turnracing/turnracing-diy/Wiki Images/Printed Grip Molds.jpeg

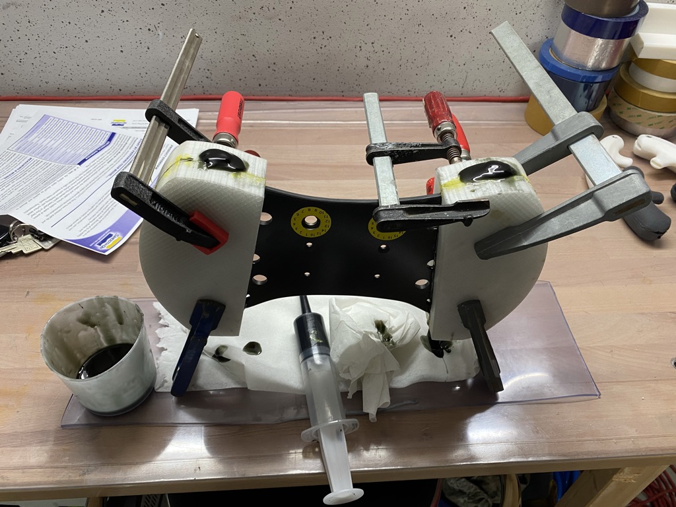
Wiki Images/Printed Grip Molds.jpeg
