turnracing/turnracing-diy/Wiki Images/bead-blasting.png

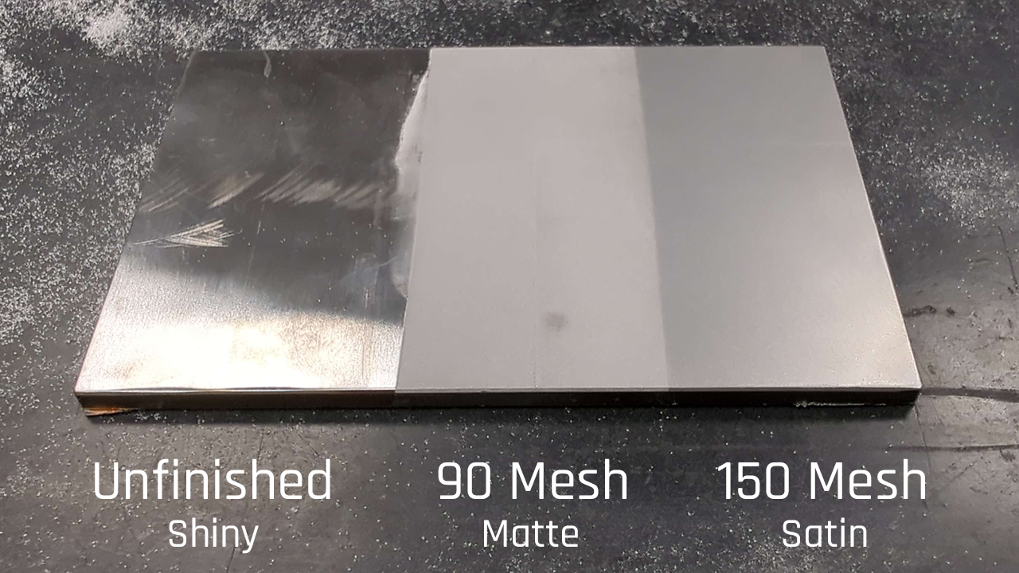
Wiki Images/bead-blasting.png
