turnracing/turnracing-diy/README.md

# Turn Racing DIY
A DIY sim racing archive by the Turn Racing community

Go to our [Wiki](https://github.com/spookeo/turnracing-diy/wiki)
