turnracing/turnracing-diy/Turn DIY Files/Turn 488 Challenge DIY Files/Renderings/Render 4.png

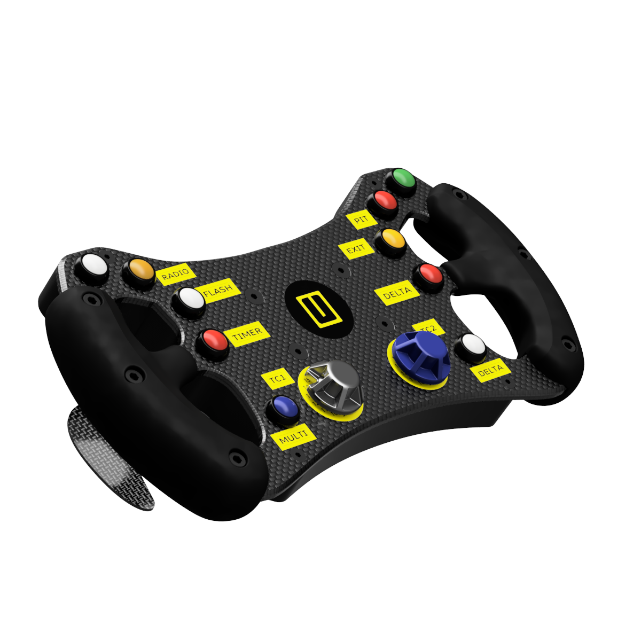
Turn DIY Files/Turn 488 Challenge DIY Files/Renderings/Render 4.png
