turnracing/turnracing-diy/Turn DIY Files/Turn 488 Challenge DIY Files/Stickers/Turn 488 Challenge Sticker Sheet Size A4-01.png

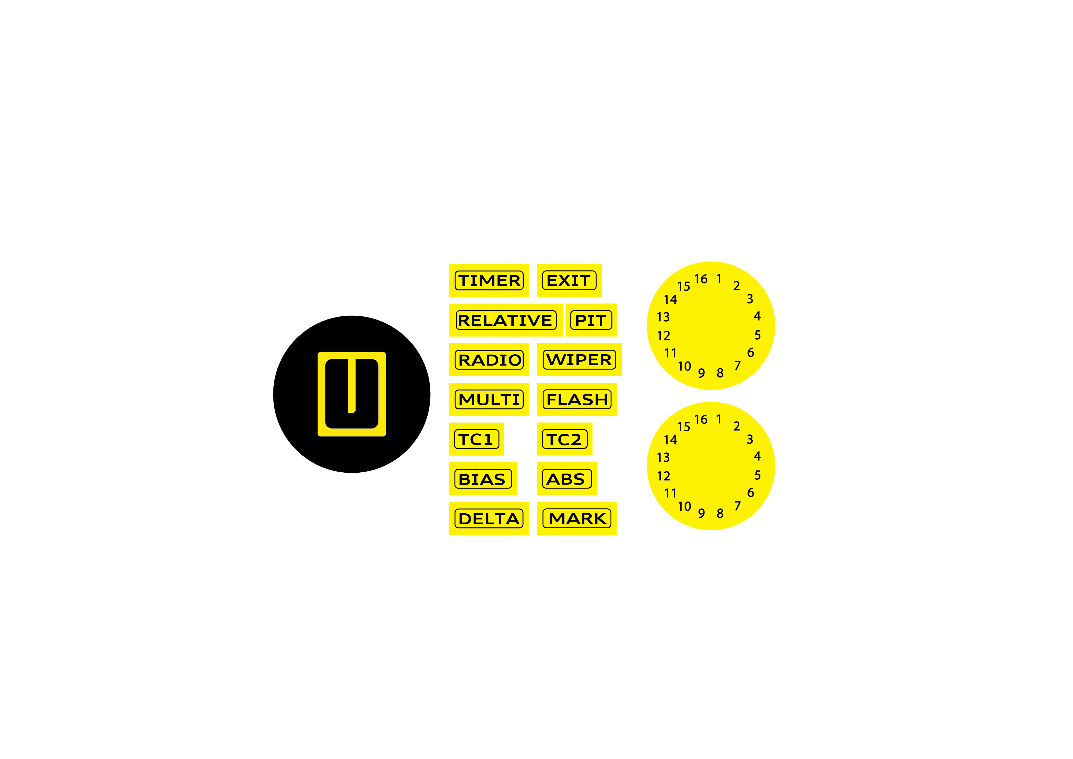
Turn DIY Files/Turn 488 Challenge DIY Files/Stickers/Turn 488 Challenge Sticker Sheet Size A4-01.png
