turnracing/turnracing-diy/Turn DIY Files/Turn 911 GT3 Cup DIY Files/Renderings/Render2.png

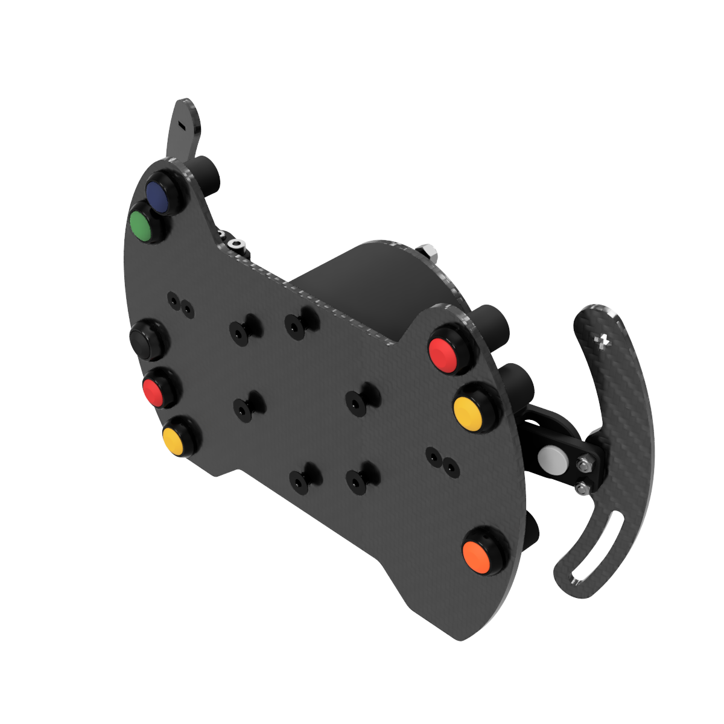
Turn DIY Files/Turn 911 GT3 Cup DIY Files/Renderings/Render2.png
