turnracing/turnracing-diy/Turn DIY Files/Turn 911 GT3 Cup DIY Files/Renderings/Render3.png

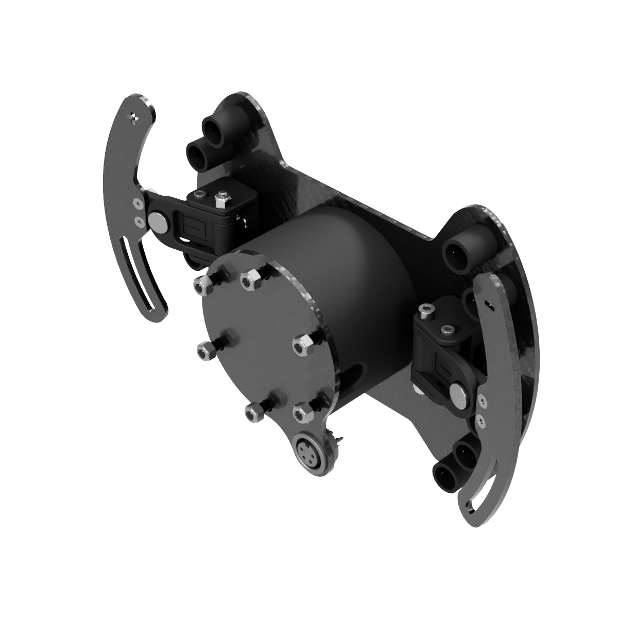
Turn DIY Files/Turn 911 GT3 Cup DIY Files/Renderings/Render3.png
