turnracing/turnracing-diy/Turn DIY Files/Turn Fiesta WRC DIY Files/Renderings/Front View.png

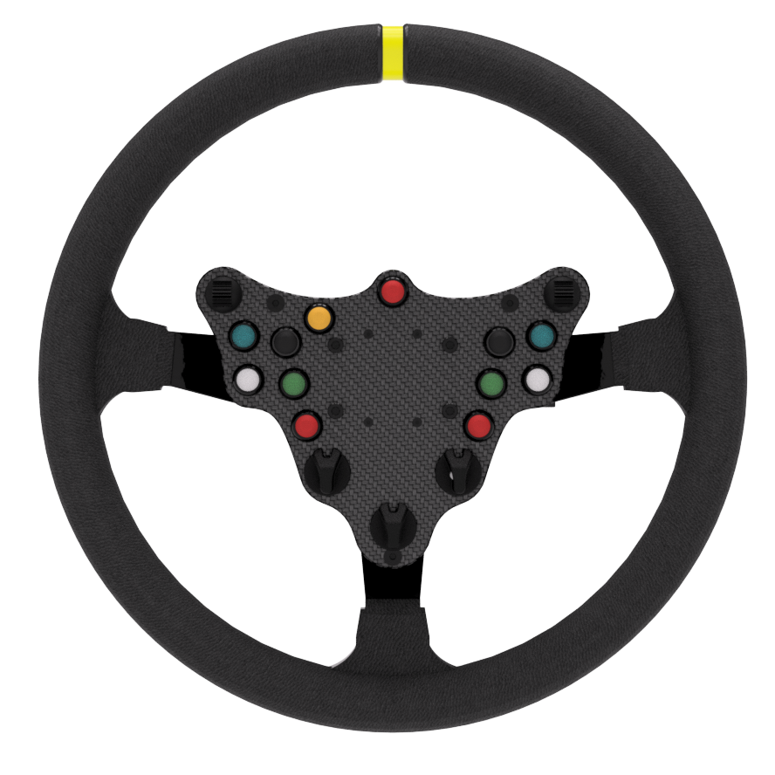
Turn DIY Files/Turn Fiesta WRC DIY Files/Renderings/Front View.png
