turnracing/turnracing-diy/Turn DIY Files/Turn Fiesta WRC DIY Files/Renderings/Rear Isometric View.png

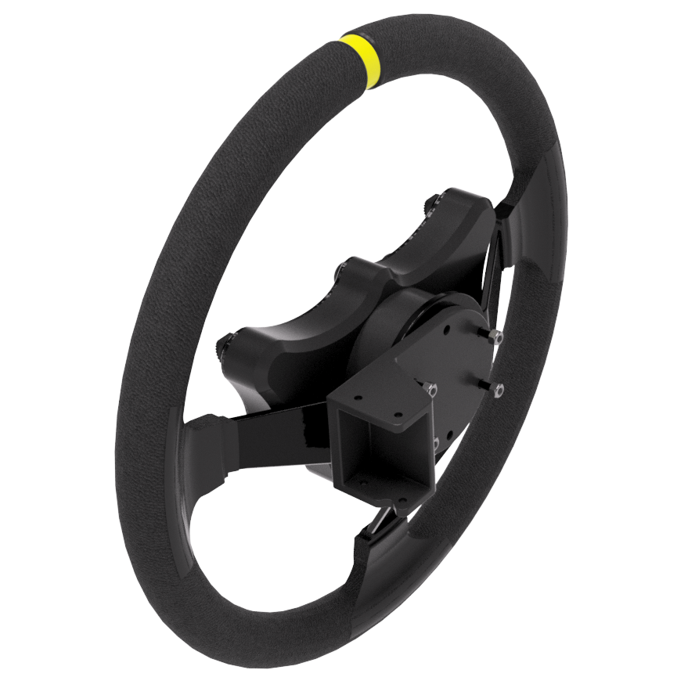
Turn DIY Files/Turn Fiesta WRC DIY Files/Renderings/Rear Isometric View.png
