turnracing/turnracing-diy/Turn DIY Files/Turn Fiesta WRC DIY Files/Stickers/Fiesta WRC Sticker Sheet.png

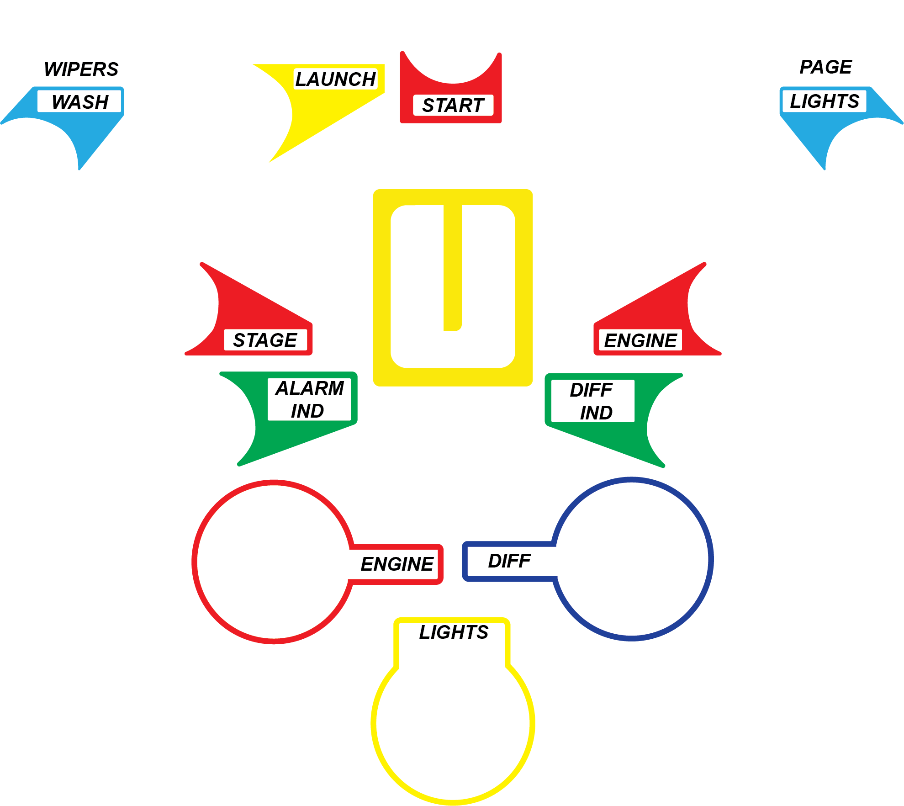
Turn DIY Files/Turn Fiesta WRC DIY Files/Stickers/Fiesta WRC Sticker Sheet.png
