turnracing/turnracing-diy/Turn DIY Files/Turn GT GT3 DIY Files/Renderings/Turn GT GT3 Steering Wheel.2.png

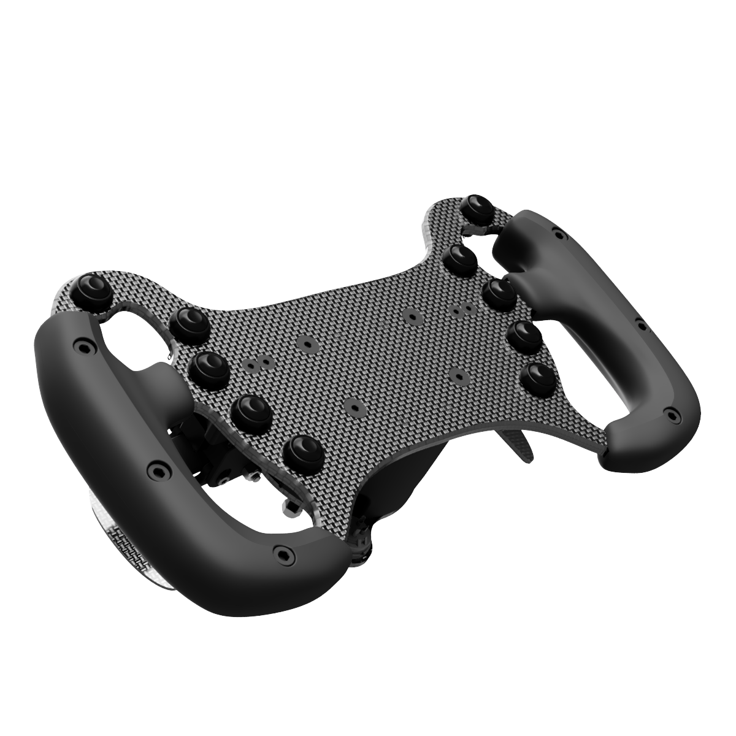
Turn DIY Files/Turn GT GT3 DIY Files/Renderings/Turn GT GT3 Steering Wheel.2.png
