turnracing/turnracing-diy/Turn DIY Files/Turn GT GT3 DIY Files/Renderings/Turn GT GT3 Steering Wheel.png

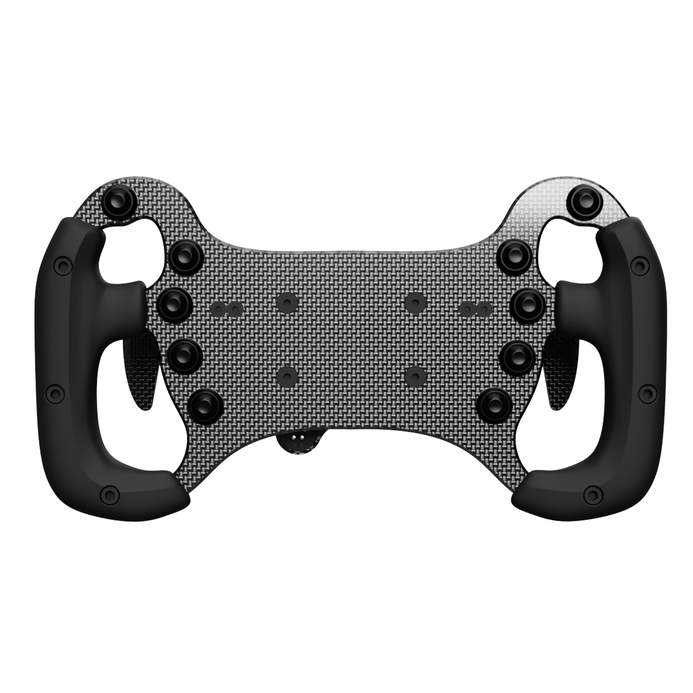
Turn DIY Files/Turn GT GT3 DIY Files/Renderings/Turn GT GT3 Steering Wheel.png
