turnracing/turnracing-diy/Turn DIY Files/Turn GT GT3 DIY Files/Turn 3d Shifter DIY Download/Renderings/Render 2.png

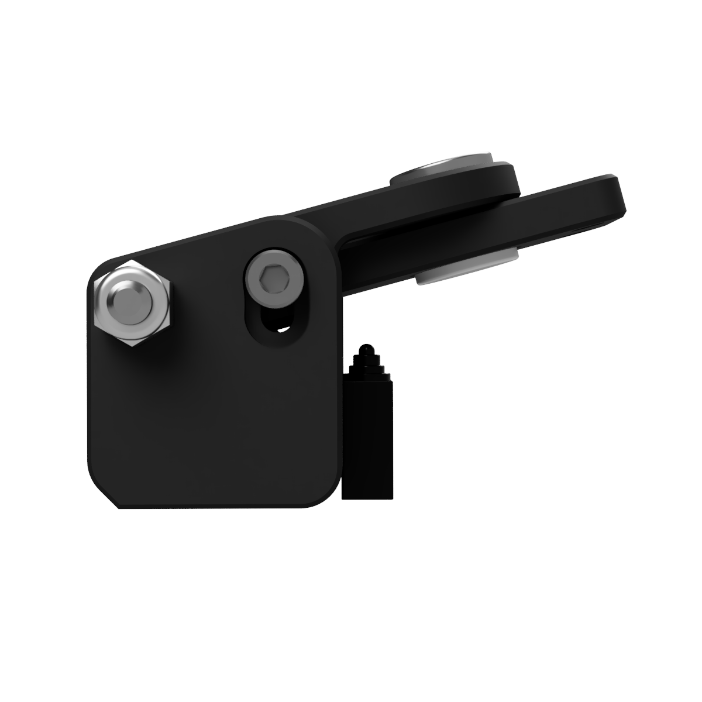
Turn DIY Files/Turn GT GT3 DIY Files/Turn 3d Shifter DIY Download/Renderings/Render 2.png
