turnracing/turnracing-diy/Turn DIY Files/Turn GTE DIY Files/Stickers/Turn GTE Sticker Sheet Size A4-01.png

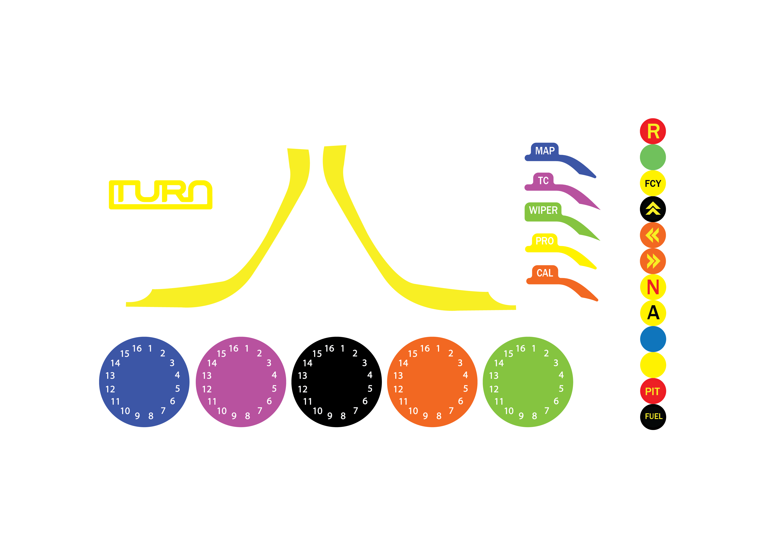
Turn DIY Files/Turn GTE DIY Files/Stickers/Turn GTE Sticker Sheet Size A4-01.png
