turnracing/turnracing-diy/Turn DIY Files/Turn R8 LMS DIY Files/Renderings/Render 1.jpg

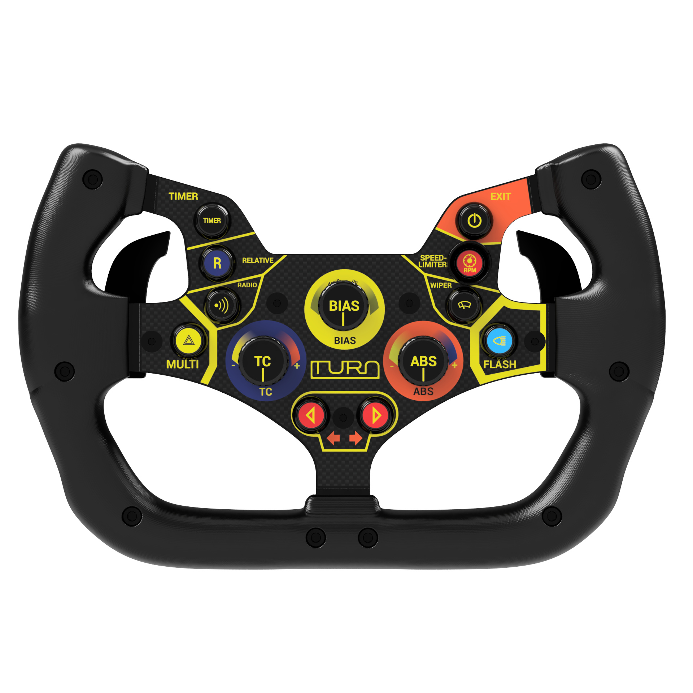
Turn DIY Files/Turn R8 LMS DIY Files/Renderings/Render 1.jpg
