turnracing/turnracing-diy/Turn DIY Files/Turn R8 LMS DIY Files/Stickers/Turn R8 Sticker Sheet Size A4.png

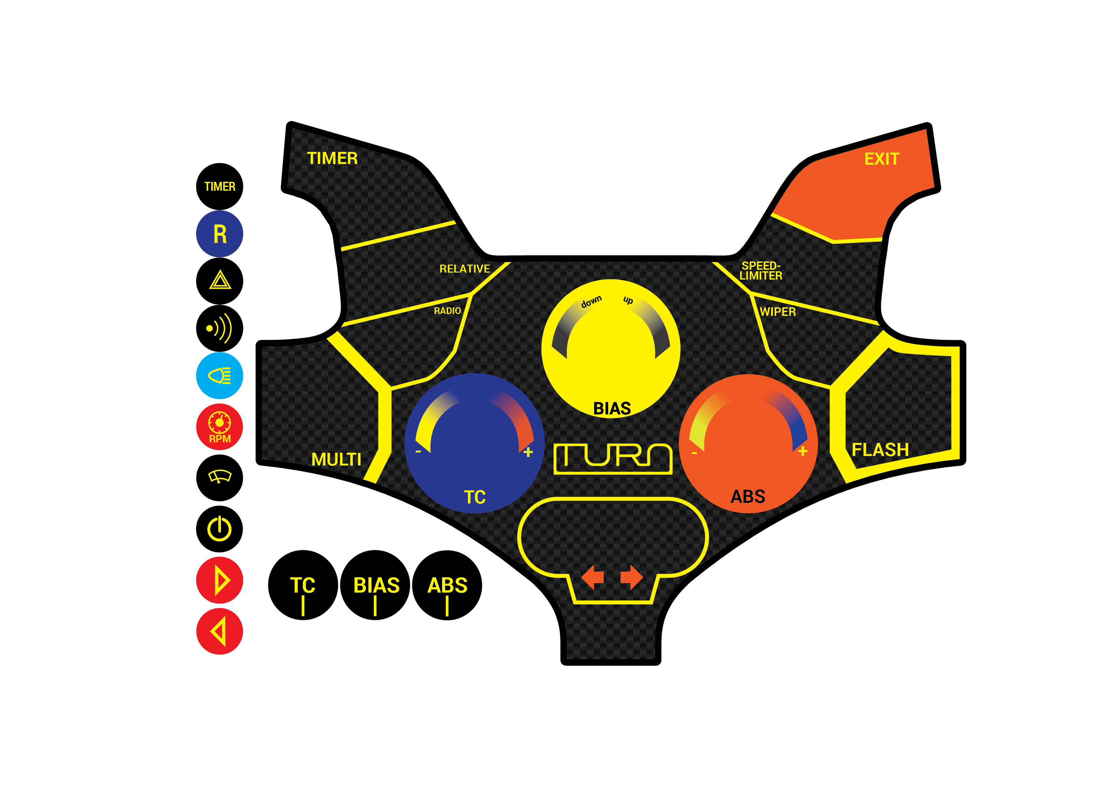
Turn DIY Files/Turn R8 LMS DIY Files/Stickers/Turn R8 Sticker Sheet Size A4.png
