turnracing/turnracing-diy/Turn DIY Files/Turn RSR-17 DIY Files/Renderings/Turn RSR-17 Back Angle.png

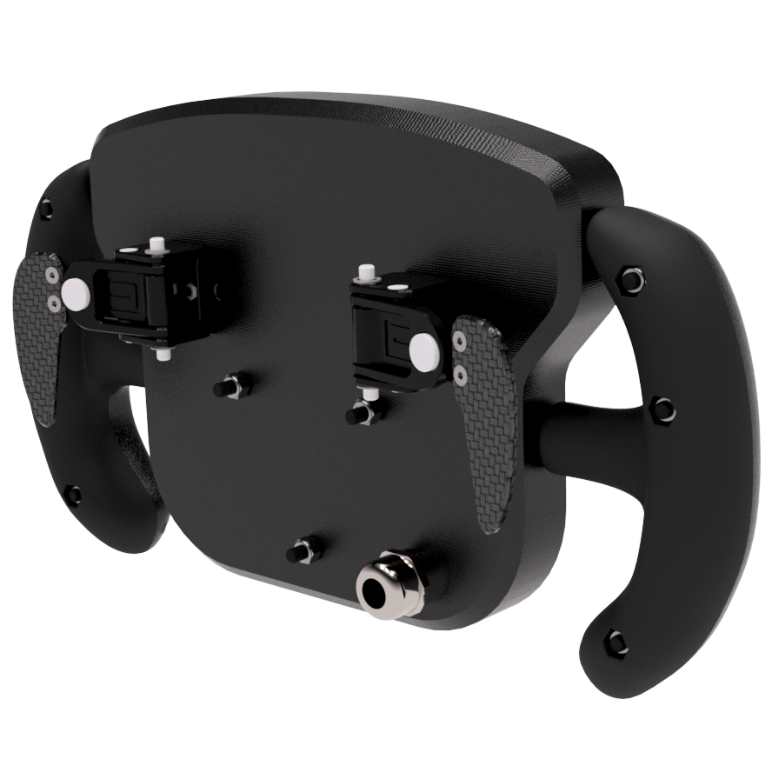
Turn DIY Files/Turn RSR-17 DIY Files/Renderings/Turn RSR-17 Back Angle.png
