turnracing/turnracing-diy/Wiki Images/Carbon-Diagonal-Left.jpg

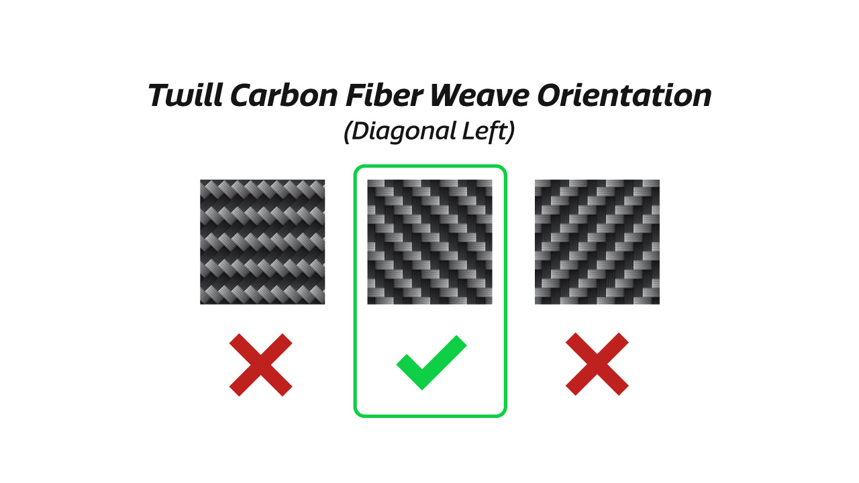
Wiki Images/Carbon-Diagonal-Left.jpg
