turnracing/turnracing-diy/Wiki Images/Carbon-Diagonal-Right.jpg

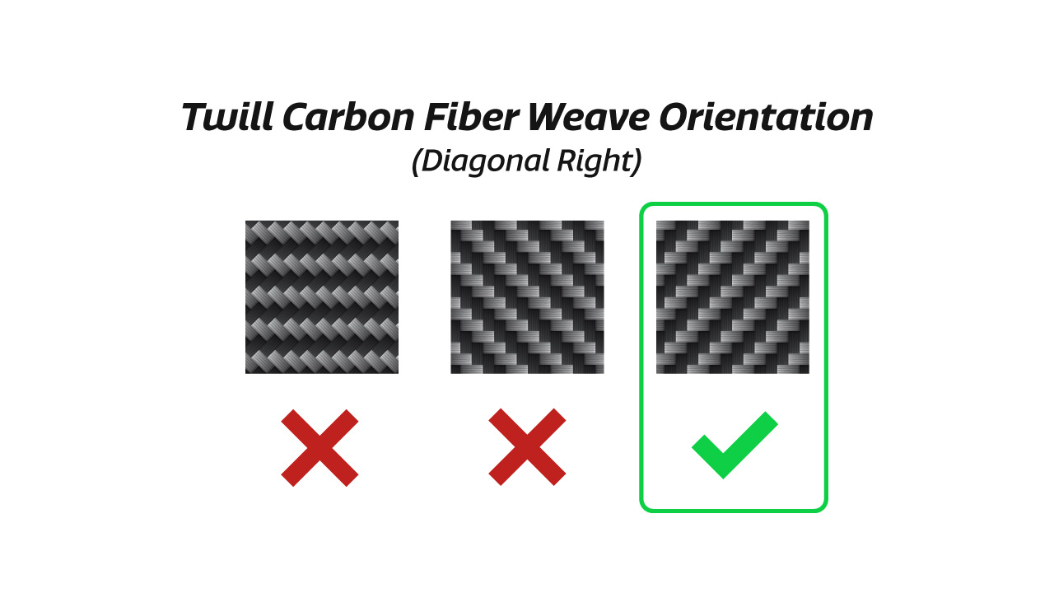
Wiki Images/Carbon-Diagonal-Right.jpg
