turnracing/turnracing-diy/Wiki Images/Fusion Save As Mesh.png

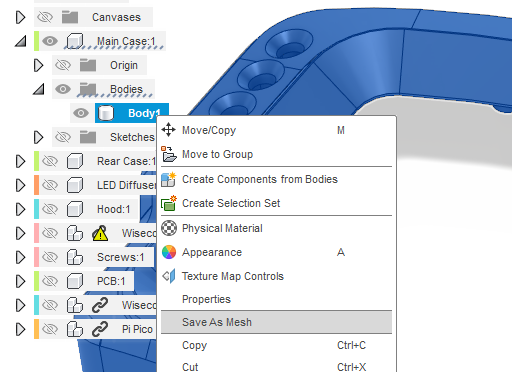
Wiki Images/Fusion Save As Mesh.png
