turnracing/turnracing-diy/Wiki Images/Fusion STL Settings.png

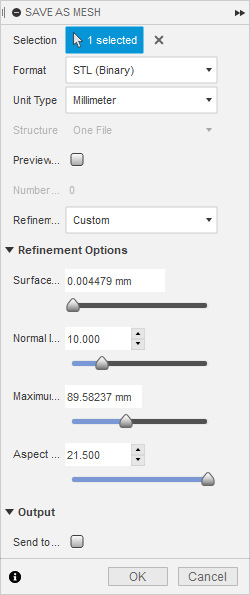
Wiki Images/Fusion STL Settings.png
