turnracing/turnracing-diy/Wiki Images/Schematics/488.png

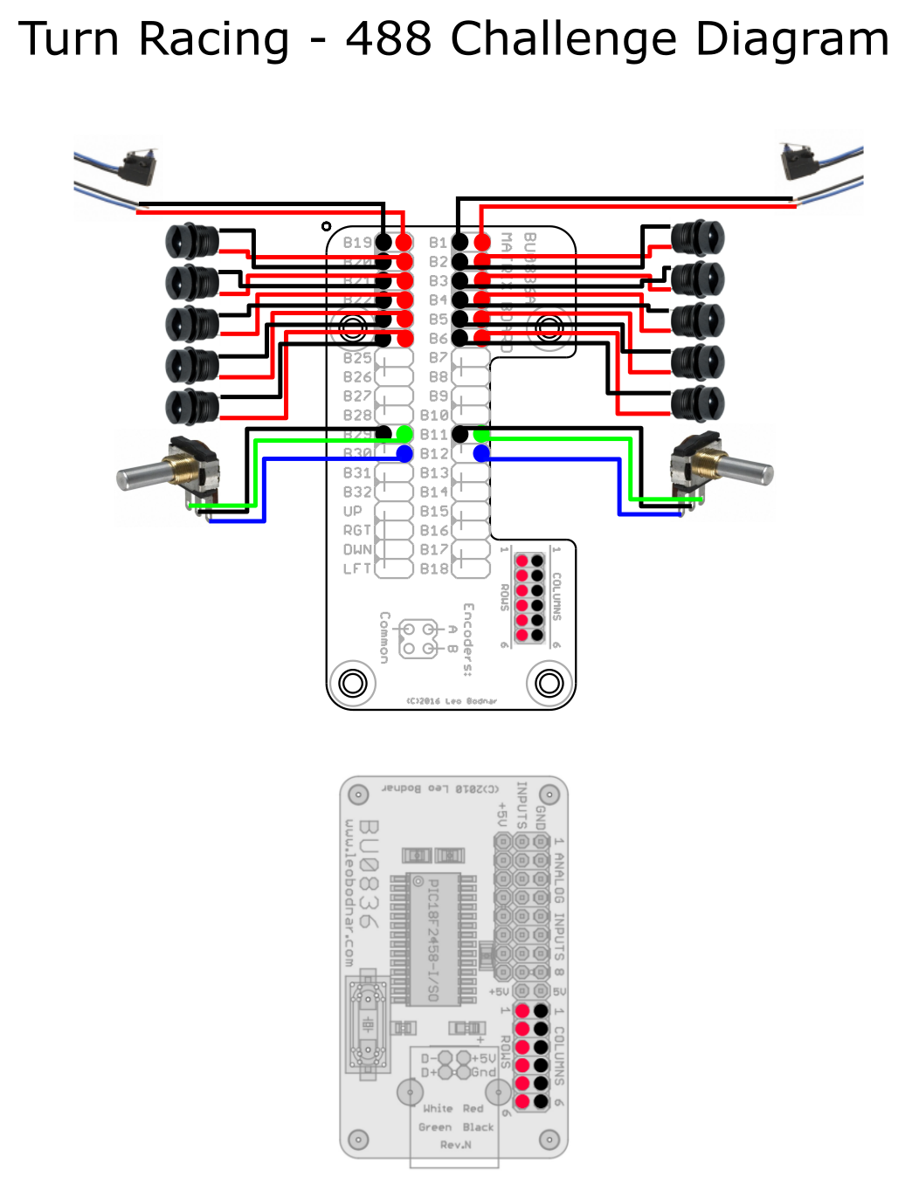
Wiki Images/Schematics/488.png
