turnracing/turnracing-diy/Wiki Images/Schematics/911.png

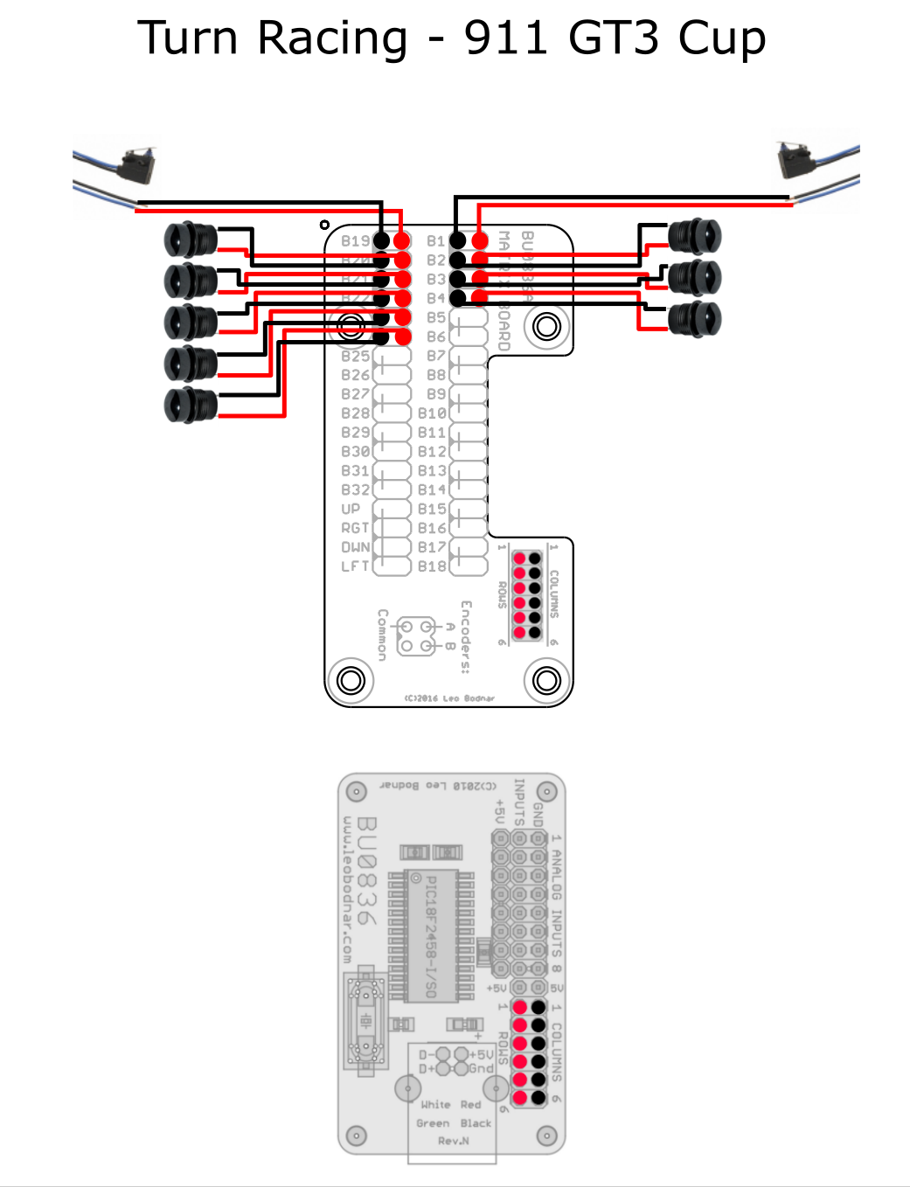
Wiki Images/Schematics/911.png
