turnracing/turnracing-diy/Wiki Images/Schematics/GTE.png

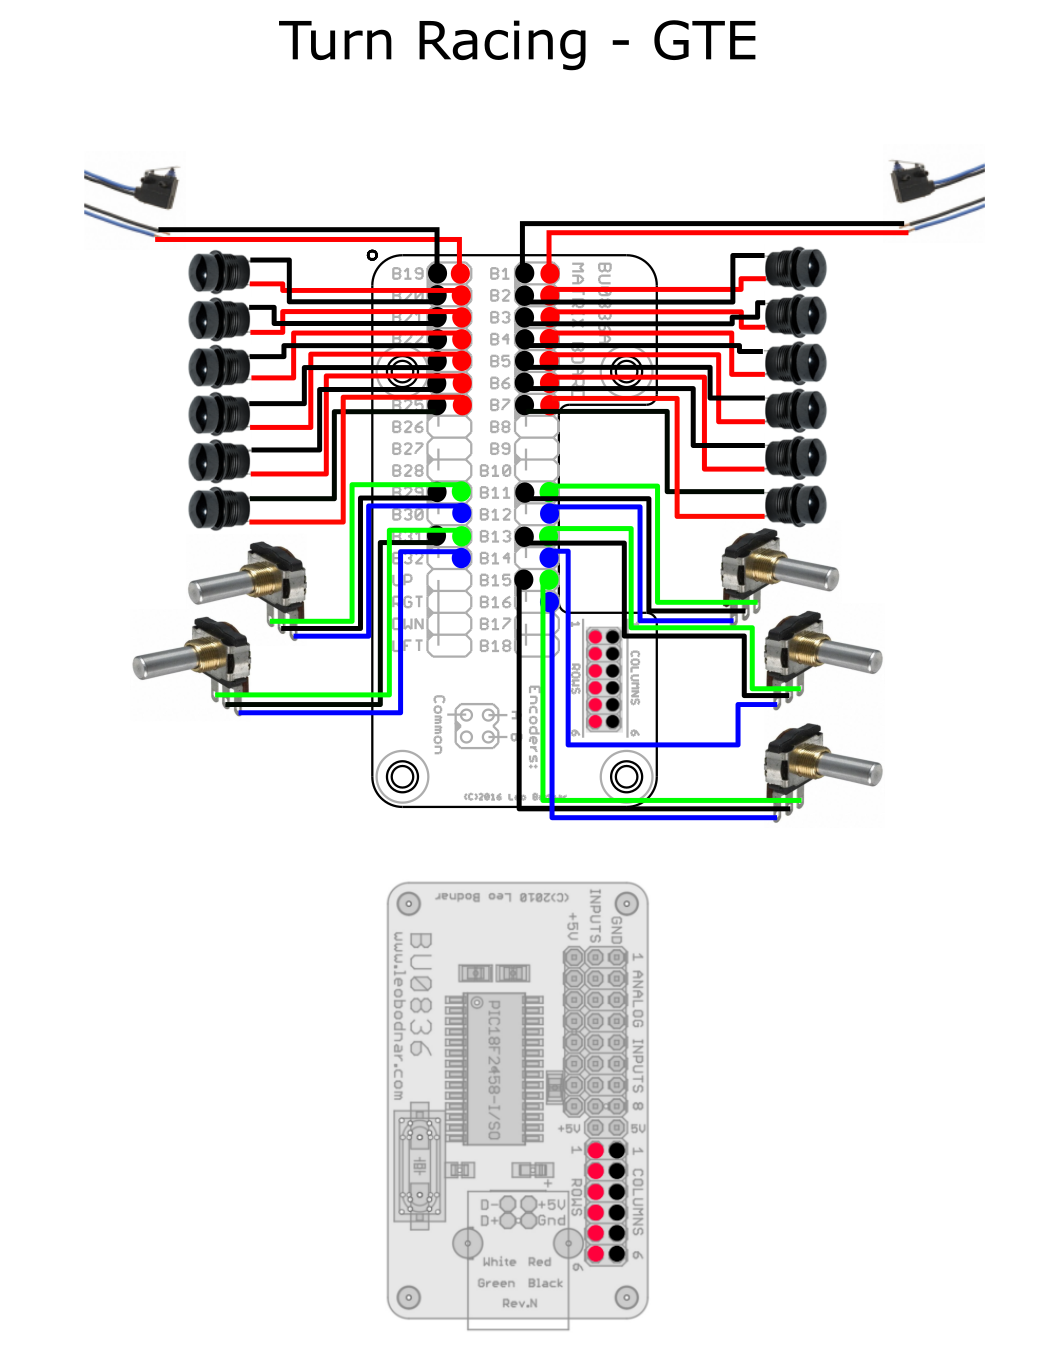
Wiki Images/Schematics/GTE.png
