turnracing/turnracing-diy/Wiki Images/Schematics/R8.png

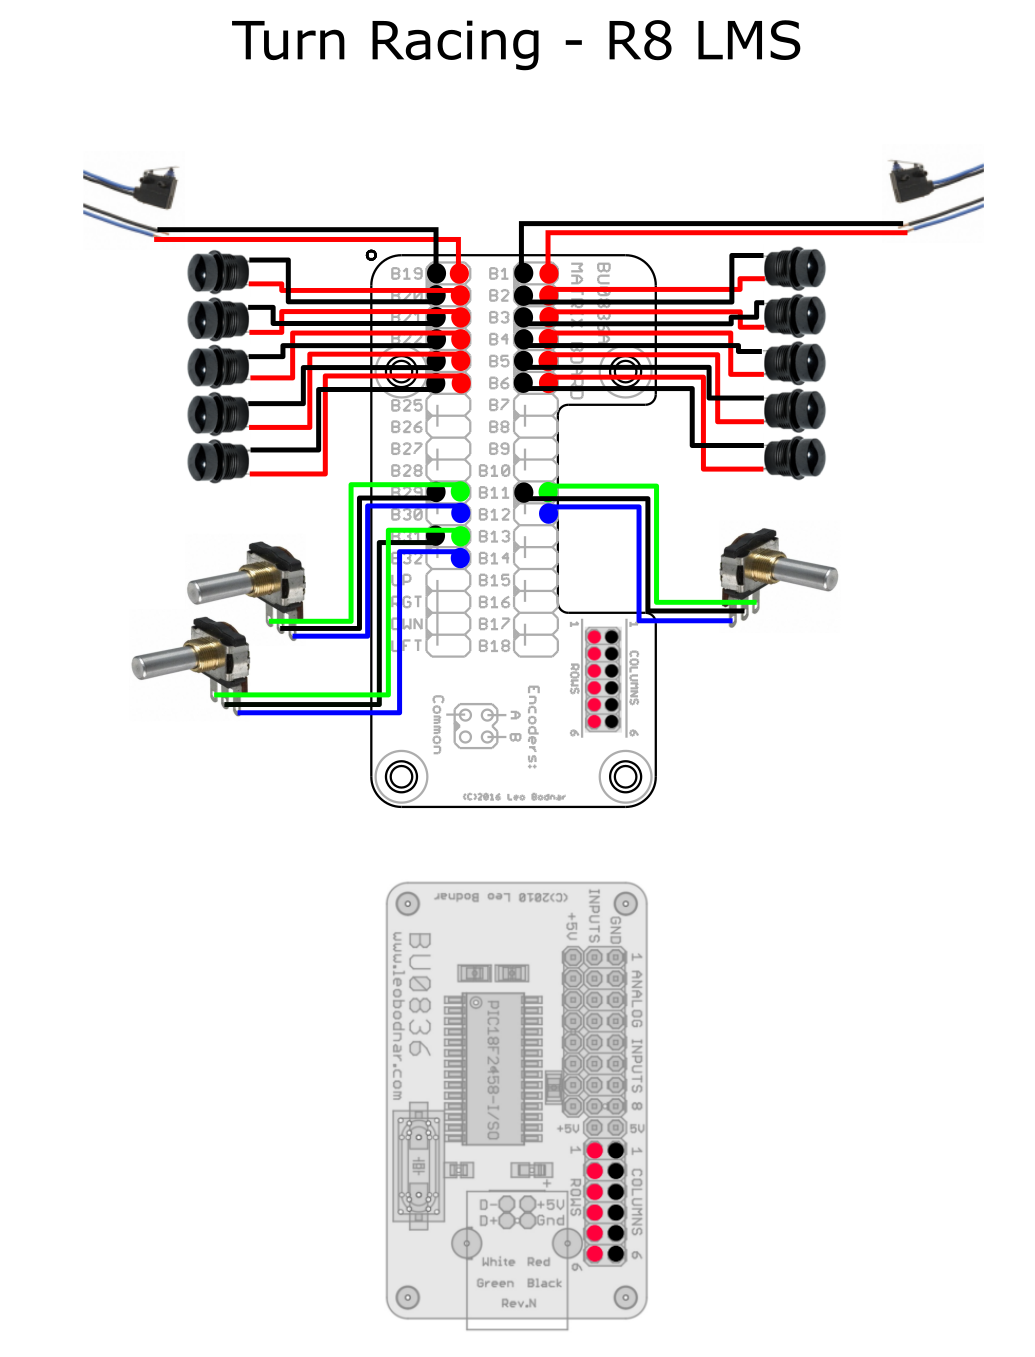
Wiki Images/Schematics/R8.png
