turnracing/turnracing-diy/Wiki Images/turn-wiki-dark.png

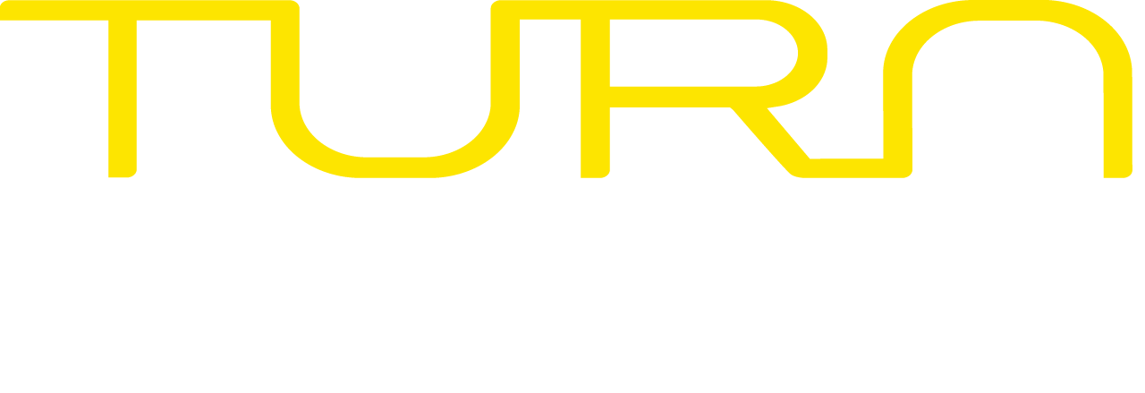
Wiki Images/turn-wiki-dark.png
