turnracing/turnracing-diy/Wiki Images/turn-wiki-light.png

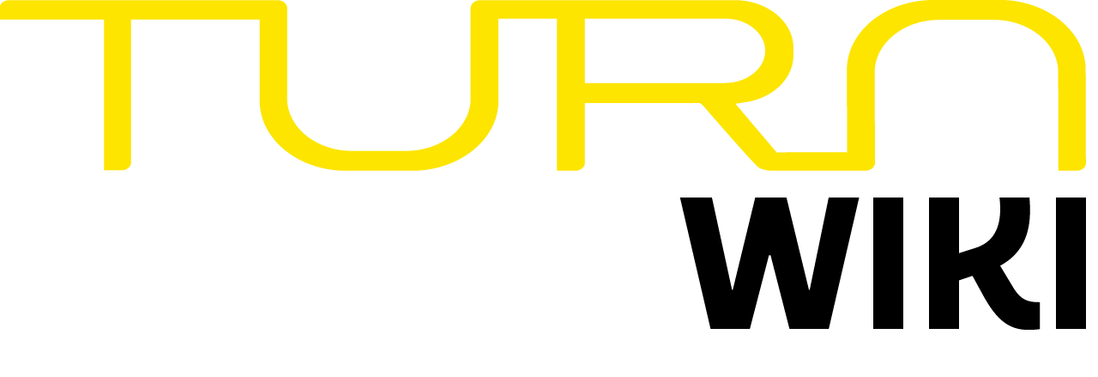
Wiki Images/turn-wiki-light.png
