turnracing/turnracing-diy/Wiki Images/via_stich_2.png

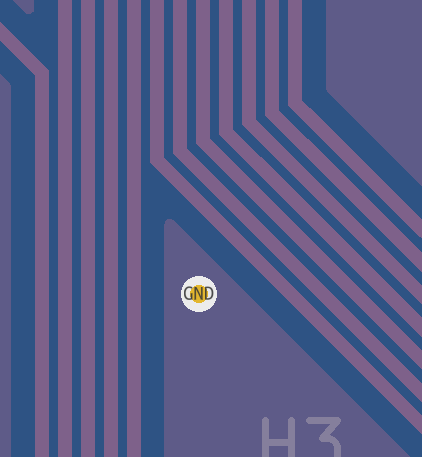
Wiki Images/via_stich_2.png
