turnracing/turnracing-diy/Wiki Images/wheel-size-chart-dark.png

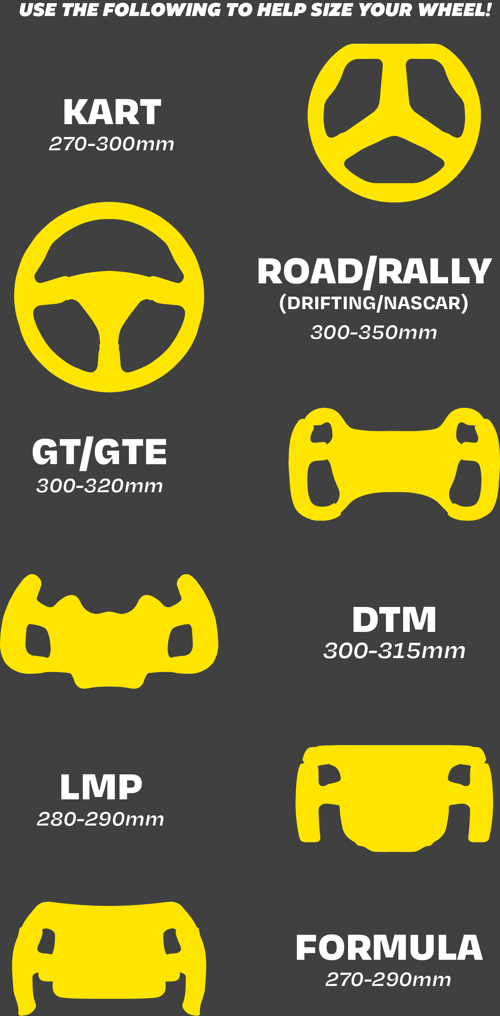
Wiki Images/wheel-size-chart-dark.png
