turnracing/turnracing-diy/Wiki Images/wheel-size-chart-light.png

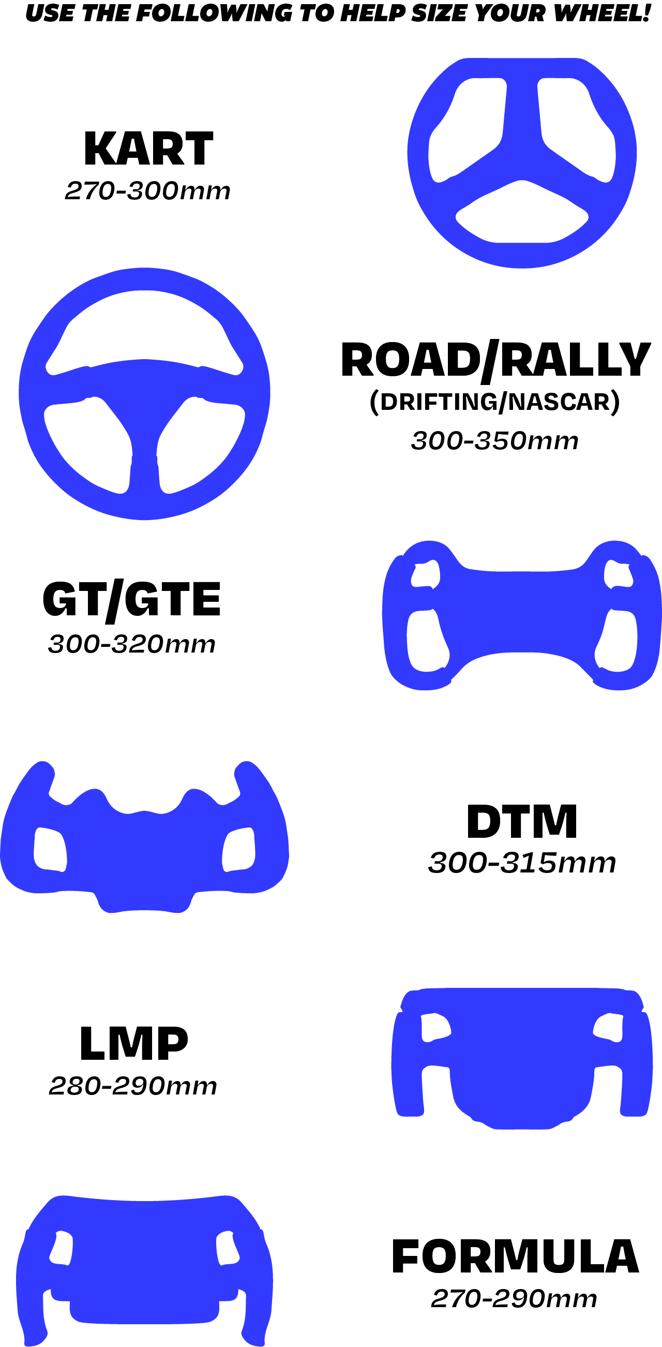
Wiki Images/wheel-size-chart-light.png
