turnracing/turnracing-diy/Turn DIY Files/Turn Fiesta WRC DIY Files/Bill of Materials/Turn Fiesta WRC DIY Bill of Materials.pdf

# TURN Fiesta WRC DIY BILL OF MATERIALS

PRODUCT NAME | Fiesta WRC | CONTACT INFO
APPROVED BY | Zach Hodgson | support@turnracing.com | Hardware Suppliers
TOTAL COST | ($ | 197.98) | https://www.albanycountyfasteners.com/
| | | https://www.accu.co.uk/en/
| | | https://www.gwr-fasteners.co.uk/
PART NUMBER | PART NAME | DESCRIPTION | PART IMAGE | QUANTITY | SUPPLIER / MANUFACTURER | UNIT COST | TOTAL PART COST
BU0836A | USB Controller | A small USB joystick interface board A small add on board that provides an easy matrix circuit for the BU0836A | | 1 | | ($ 35.43) | ($ 35.43)
BU0836A | Breakout Board | | | 1 | | ($ 21.25) | ($ 21.25)
PV5S24011 | E-Switch Push Button | momentary switch | | 12 | | ($ 4.51) | ($ 54.12)
MTG72AD2 | Apem Trim Switch | Toggle Switches SWITCH TOGGLE SEALED MOM-OFF-MOM | | 2 | | ($ 43.49) | ($ 86.98)
CTS 288 Short Shaft | Rotary Encoder | Shaft Length: 10.5mm - 16 detents per revolution - 1 pulse per detent - 1:1 mode in our encoder config software - Shaft diameter: 1/4" | | 3 | | ($ 6.37) | ($ 19.11)
| M2.5 Hexagon Nylon Lock Nut | | | 12 | | ($ 0.62) | ($ 7.44)

http://www.leobodnar.com/shop/index.php?main_page=product_info&cPath=94&products_id=204

http://www.leobodnar.com/shop/index.php?main_page=product_info&cPath=94&products_id=274

https://www.digikey.com/product-detail/en/e-switch/PV5S24011/EG5949-ND/4028816

https://www.mouser.com/ProductDetail/642-MTG72AD2

http://www.leobodnar.com/shop/index.php?main_page=product_info&cPath=98_75&products_id=243

https://www.accu.co.uk/en/hexagon-nylon-locking-nuts/7944-HNN-M3-A2

# TURN Fiesta WRC DIY BILL OF MATERIALS

M5 Hexagon Nylon Lock

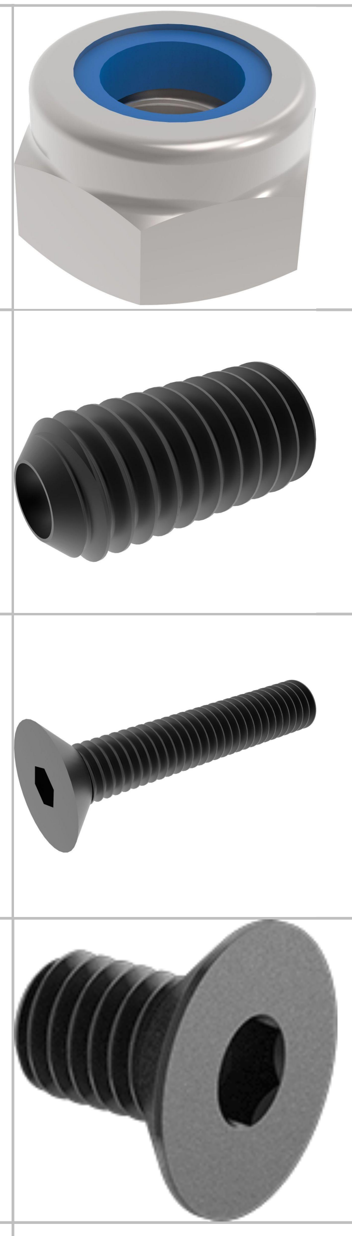
[picture p42: figure]

Nut | 4

https://www.accu.co.uk/en/hexagon-nylon-locking-nuts/7947-HNN-M5-A2

($ | 0.72) | ($ | 2.88)
M4 x 6mm Set Screw | Set Screw for rotary encoder knobs | 3

https://www.accu.co.uk/en/cup-point-set-screws/152976-SSU-M4-6-A2-BL

($ | 0.44) | ($ | 1.32)

M2.5 x 25mm Flat Head
Screw | Flat head Screw | 4

https://www.mcmaster.com/91294A540/

($ | 0.52) | ($ | 2.08)

M3 x 10mm Flat Head
Screw | Flat Head Screw | 3

https://www.accu.co.uk/en/countersunk-socket-head-screws/153275-SSK-M5-10-A2-BL

($ | 0.44) | ($ | 1.32)
M5 x 80mm Socket Screw | Countersunk Screw | 4

https://www.accu.co.uk/en/cap-head-screws/16058-SSC-M5-80-12-9

($ | 0.37) | ($ | 1.48)
TOTAL | ($ | 197.98)

# Copyright © 2020 Turn Racing, LLC. All rights reserved
