turnracing/turnracing-diy/Turn DIY Files/Turn R8 LMS DIY Files/Bill of Materials/Turn R8 LMS DIY Bill of Materials.pdf

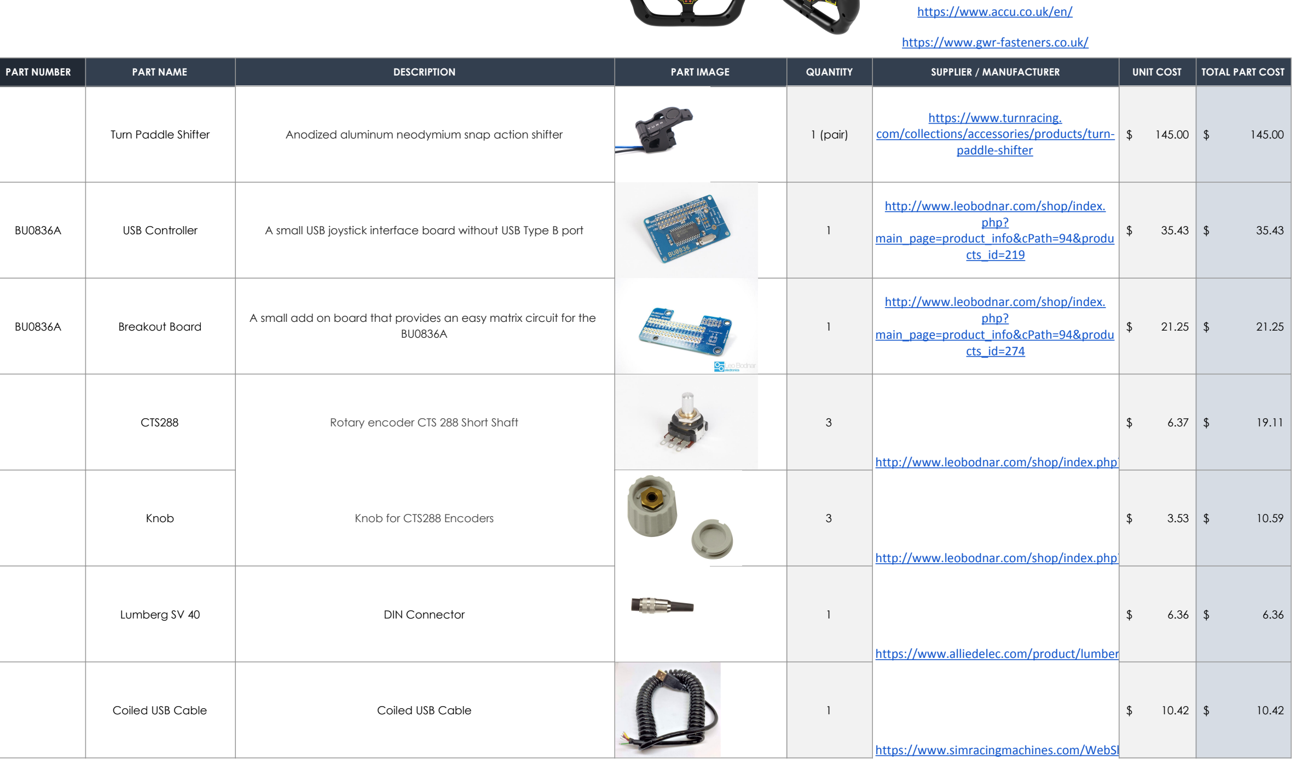
[picture p44: figure]
https://www.accu.co.uk/en/; https://www.gwr-fasteners.co.uk/; PART NUMBER; PART NAME; DESCRIPTION; PART IMAGE; QUANTITY; SUPPLIER / MANUFACTURER; UNIT COST; TOTAL PART COST; paddle-shifter; http://www.leobodnar.com/shop/index. php? main_page=product_info&cPath=94&produ cts_id=219; http://www.leobodnar.com/shop/index. php? main_page=product_info&cPath=94&produ cts_id=274; http://www.leobodnar.com/shop/index.php?main_page=product_info&cPath=98_75&products_id=243; Knob; http://www.leobodnar.com/shop/index.php?main_page=product_info&cPath=98_75&products_id=198; Lumberg SV 40; DIN Connector; https://www.alliedelec.com/product/lumberg/sv-40/70151555/; Coiled USB Cable; https://www.simracingmachines.com/WebShop/coiled-usb-cable

### Copyright©2020 Turn Racing LLC All rights reserved

## Turn R8 LMS DIY BILL OF MATERIALS

PRODUCT NAME | Turn R8 LMS | CONTACT INFO

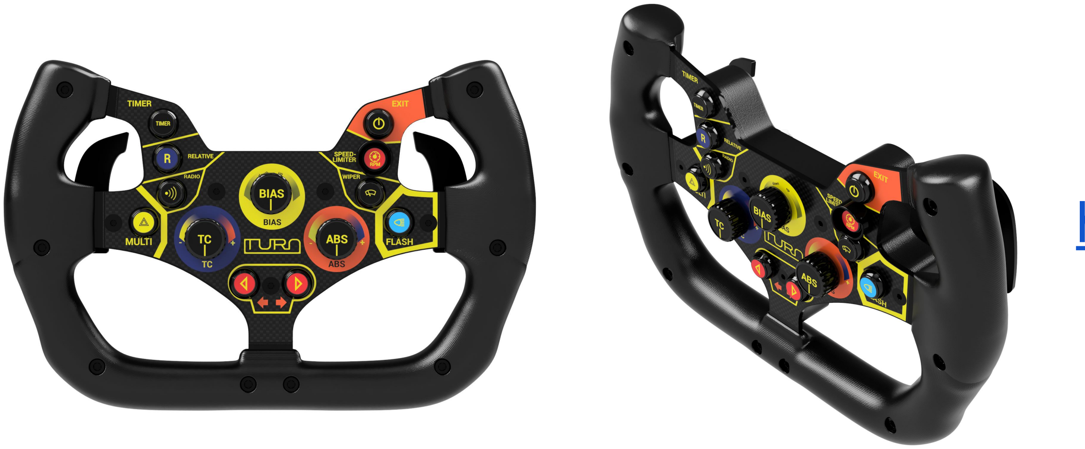
[picture p45: figure]

APPROVED BY | Zach Hodgson | support@turnracing.com | Hardware Suppliers
TOTAL COST | Varies | https://www.albanycountyfasteners.com/
| Turn Paddle Shifter | Anodized aluminum neodymium snap action shifter | | 1 (pair) | https://www.turnracing.com/collections/accessories/products/turn- | ($ 145.00) | ($ 145.00)
BU0836A | USB Controller | A small USB joystick interface board without USB Type B port | 1
BU0836A | Breakout Board | A small add on board that provides an easy matrix circuit for the
CTS288 | Rotary encoder CTS 288 Short Shaft Knob for CTS288 Encoders | 3 | ($ 6.37) | ($ 19.11)

## Turn R8 LMS DIY BILL OF MATERIALS

IPP3SAD2

Apem Black Flat Top Push
Button

This is the same button used in the real car. They are what I use on the Turn R8 LMS wheel as well. They are quite expensive and difficult to source so I put a link to a page that shows several suppliers with prices

10 | https://octopart.com/ipp3sad2-apem-
7548694 (https://octopart.com/ipp3sad2-apem-7548694) | ($ | 23.58) | ($ | 235.80)

GPB556A05BB

CW Industries Push Button | Low cost flat top button alternative | 10

https://www.digikey.
com/en/products/detail/cwindustries/GPB556A05BB/3193531 (https://www.digikey.com/en/products/detail/cw-industries/GPB556A05BB/3193531)
($ | 5.77) | ($ | 57.70)
PV5S24011 | E-Switch Push Button | momentary switch (domed) | 10 | https://www.digikey.com/product-detail/en/e-switch/PV5S24011/EG5949-ND/4028816 (https://www.digikey.com/product-detail/en/e-switch/PV5S24011/EG5949-ND/4028816) | ($ 4.51) | ($ 45.10)
| M2.5 x 25mm Flathead | M2.5 x 0.45 mm Thread, 25 mm Long | 4 | https://www.mcmaster.com/91294A540/ | ($ 0.52) | ($ 2.08)

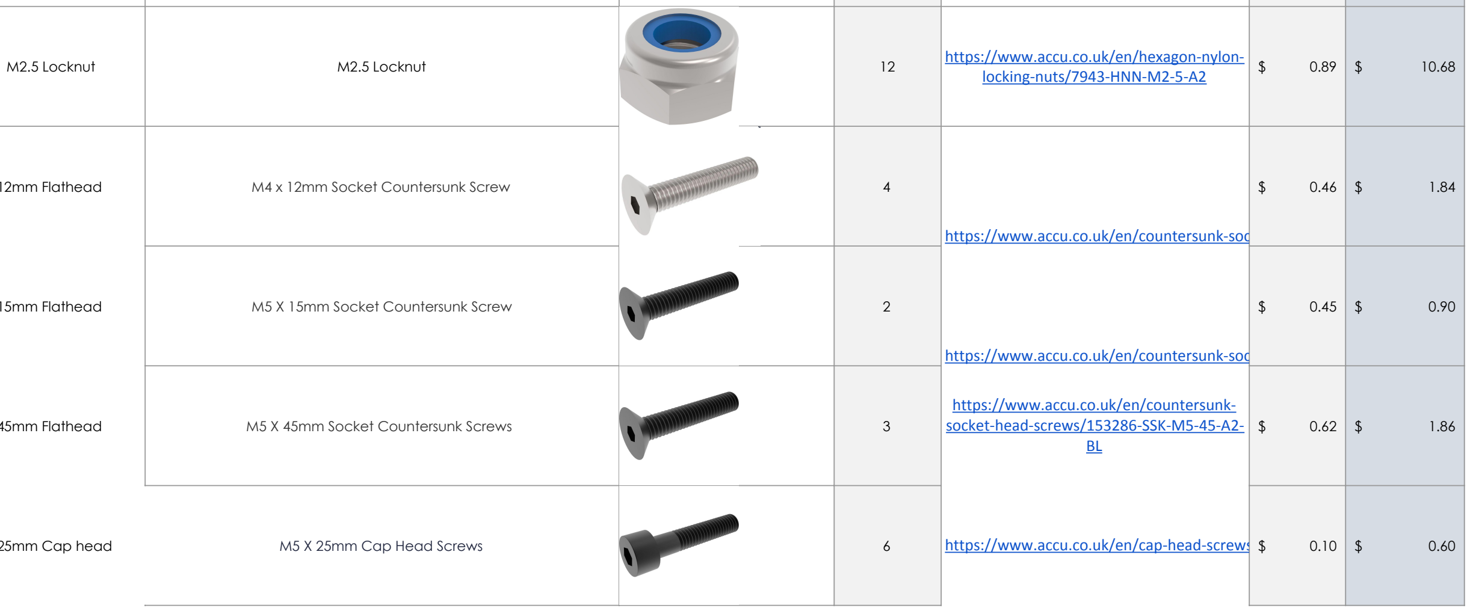
[picture p46: figure]
M2.5 Locknut; https://www.accu.co.uk/en/hexagon-nylon-; locking-nuts/7943-HNN-M2-5-A2; https://www.accu.co.uk/en/countersunk-socket-head-screws/5448-SSK-M4-12-A2; https://www.accu.co.uk/en/countersunk-socket-head-screws/153286-SSK-M5-45-A2-; https://www.accu.co.uk/en/countersunk-socket-head-screws/153277-SSK-M5-14-A2-BL

M4 x 12mm Flathead | M4 x 12mm Socket Countersunk Screw | 4
M5 x 15mm Flathead | M5 X 15mm Socket Countersunk Screw | 2
M5 x 45mm Flathead | M5 X 45mm Socket Countersunk Screws | 3
M5 x 25mm Cap head | M5 X 25mm Cap Head Screws | 6 | https://www.accu.co.uk/en/cap-head-screws/16048-SSC-M5-25-12-9 ($ | 0.10) | ($ | 0.60)

## Turn R8 LMS DIY BILL OF MATERIALS

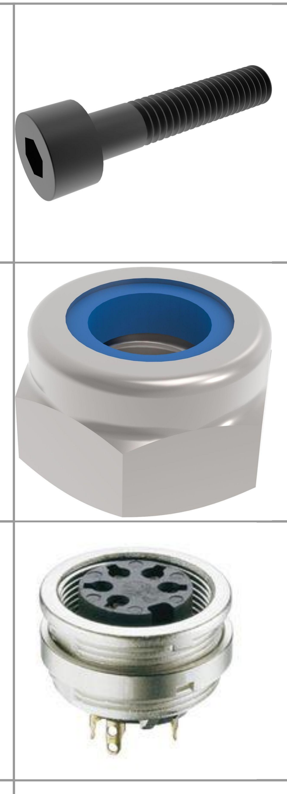
[picture p47: figure]

M5 x 20mm Cap head | M5 X 20mm Full Thread Cap Head Screws | 2

https://www.accu.co.uk/en/cap-head-screws/16046-SSCF-M5-20-12-9

($ | 0.08) | ($ | 0.16)
M5 Nylon Locknut | M5 Locknut | 11 | https://www.accu.co.uk/en/hexagon-nylon-
locking-nuts/7947-HNN-M5-A2 (https://www.accu.co.uk/en/hexagon-nylon-locking-nuts/7947-HNN-M5-A2) | ($ | 0.72) | ($ | 7.92)
KVF 40 | 4 pin connector | Connector Socket PA GF (Body) Front Mount VDC IEC Approved | 1

https://www.alliedelec.
com/product/lumberg/kfv-40/70151670/ (https://www.alliedelec.com/product/lumberg/kfv-40/70151670/) | ($ | 3.27) | ($ | 3.27)
TOTAL | Varies
