turnracing/turnracing-diy/Turn DIY Files/Turn RSR-17 DIY Files/Bill of Materials/Turn RSR 2017 DIY Bill of Materials.pdf

# TURN RSR 2017 DIY BILL OF MATERIALS

PRODUCT NAME | RSR-17 | CONTACT INFO
APPROVED BY | Zach Hodgson | support@turnracing.com | Hardware Suppliers
TOTAL COST | ($ | 266.81) | https://www.albanycountyfasteners.com/
| | | https://www.accu.co.uk/en/
| | | https://www.gwr-fasteners.co.uk/
PART NUMBER | PART NAME | DESCRIPTION | PART IMAGE | QUANTITY | SUPPLIER / MANUFACTURER | UNIT COST | TOTAL PART COST
93890A560 | Headless Clevis Pin With Retaining Ring Groove | Install or remove these pins from either side. Slide the included retaining rings into the grooves for a secure hold | | 2 | | ($ 4.86) | ($ 9.72)
D2HW-BR213MR | Snap Action Limit Switch | SWITCH SNAP SPST-NO 100MA 125V | | 2 | | ($ 8.05) | ($ 16.10)
D73 | 7/16" dia. x 3/16" Thick | Disc/Cylinder Neodymium Magnet | | 4 | | ($ 1.06) | ($ 4.24)
USBD480-WQ43 | 4.3" TFT Display | 4.3" TFT display with USB interface for use with a PC or embedded devices with USB host. Thanks to the Hi-Speed USB interface used it is possible to stream video to the display. | | 1 | | ($ 96.40) | ($ 96.40)
PV5S24011 | E-Switch Push Button | momentary switch | | 10 | | ($ 4.51) | ($ 45.10)
BBI-32 | Leo Bodnar USB Controller | A low profile version of the regular BBI-32. Exactly the same features but without the push in terminals or USB connector allowing you to solder your own USB connection to the labelled solder tabs. | | 1 | | ($ 28.34) | ($ 28.34)
CTS 288 Short Shaft | Rotary Encoder | Shaft Length: 10.5mm - 16 detents per revolution - 1 pulse per detent - 1:1 mode in our encoder config software - Shaft diameter: 1/4" | | 5 | | ($ 6.37) | ($ 31.80)

https://www.mcmaster.com/93890a560

https://www.digikey.com/product-detail/en/D2HW-BR213MR/SW728-ND/404511/?itemSeq=321565507

https://www.kjmagnetics.com/proddetail.asp?prod=D73

http://www.lcdinfo.com/products/usbd480-wq43.html

https://www.digikey.com/product-detail/en/e-switch/PV5S24011/EG5949-ND/4028816

http://www.leobodnar.com/shop/index.php?main_page=product_info&cPath=94&products_id=206

http://www.leobodnar.com/shop/index.php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

($ | 3.72) | ($ | 3.72)

https://www.accu.co.uk/en/hexagon-nylon-locking-nuts/7944-HNN-M3-A2

($ | 0.62) | ($ | 9.92)

https://www.accu.co.uk/en/hexagon-nylon-locking-nuts/7947-HNN-M5-A2

($ | 0.72) | ($ | 6.48)

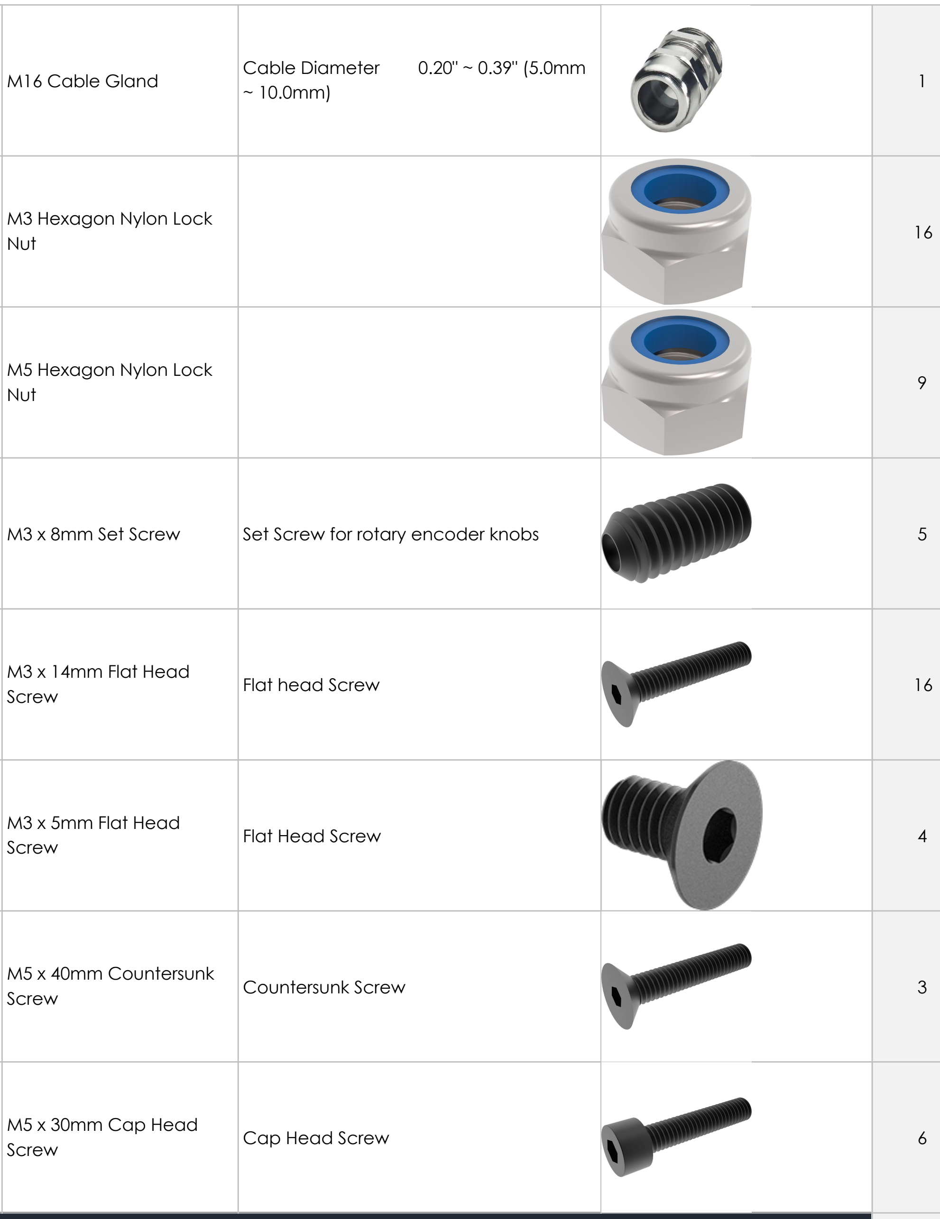
[picture p48: figure]
M16 Cable Gland; Cable Diameter; M3 Hexagon Nylon Lock; Nut; M5 Hexagon Nylon Lock; M3 x 14mm Flat Head; Screw; Flat head Screw; M3 x 5mm Flat Head; Flat Head Screw; M5 x 40mm Countersunk; Countersunk Screw; M5 x 30mm Cap Head; Cap Head Screw

M3 x 8mm Set Screw | Set Screw for rotary encoder knobs | 5

https://www.accu.co.uk/en/cup-point-set-screws/152960-SSU-M3-8-A2-BL

($ | 0.42) | ($ | 2.10)

https://www.accu.co.uk/en/countersunk-socket-head-screws/153239-SSK-M3-14-A2-BL

($ | 0.40) | ($ | 6.40)

https://www.accu.co.uk/en/countersunk-socket-head-screws/409226-SSK-M3-5-A4-BL

($ | 0.40) | ($ | 1.60)

https://www.accu.co.uk/en/countersunk-socket-head-screws/153285-SSK-M5-40-A2-BL

($ | 0.59) | ($ | 1.77)

https://www.accu.co.uk/en/cap-head-screws/152222-SSCF-M5-30-A2-BL

($ | 0.52) | ($ | 3.12)
TOTAL | ($ | 266.81)

## Copyright © 2020 Turn Racing, LLC. All rights reserved
