turnracing/turnracing-diy/Turn DIY Files/Turn GT GT3 DIY Files/Turn 3d Shifter DIY Download/Bill of Materials/Turn 3d Shifter Bill of Materials.pdf

# TURN 3D SHIFTER BILL OF MATERIALS

PRODUCT NAME | Turn 3d Shifter | CONTACT INFO
APPROVED BY | Zach Hodgson | support@turnracing.com
PART COUNT | 11
TOTAL COST | ($ 13.67)

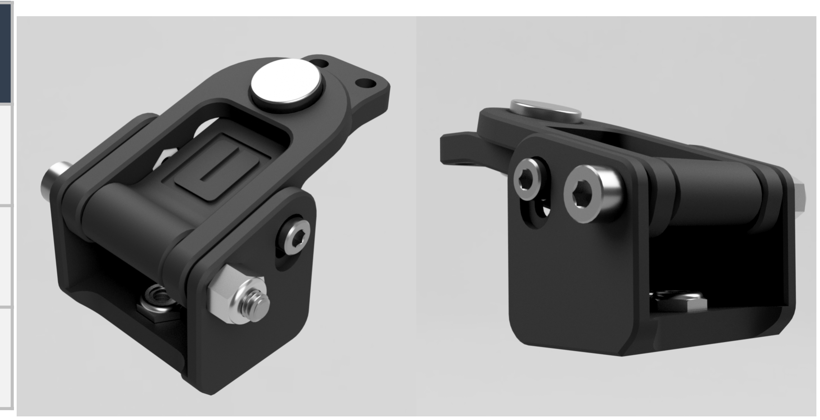
[picture p49: figure]

PART NUMBER | PART NAME | DESCRIPTION | PART IMAGE | QUANTITY | SUPPLIER / MANUFACTURER | UNIT COST | TOTAL PART COST
| M4 x 40mm Socket Head | M4 x 40mm Socket Head Screw | | 1 | | ($ 0.60) | ($ 0.60)
| M3 x 5mm Socket Head | M3 x 5mm Socket Head Screw | | 2 | | ($ 0.41) | ($ 0.82)
| M4 Locknut | M4 Locknut | | 3 | | ($ 0.42) | ($ 1.26)
| M3 Hex Nut | M3 Hex Nut | | 2 | | ($ 0.41) | ($ 0.82)
D2HW-BR213MR | Snap Action Limit Switch | SWITCH SNAP SPST-NO 100MA 125V | | 1 | | ($ 8.05) | ($ 8.05)
D73 | 7/16" dia. x 3/16" Thick | Disc/Cylinder Neodymium Magnet | | 2 | | ($ 1.06) | ($ 2.12)
PARTS PER SHIFTER | | | | 11 SUB-TOTAL | | | ($ 13.67)
PARTS PER PAIR OF SHIFTERS | | | | 22 TOTAL | | | ($ 27.34)

https://www.accu.co.uk/en/cap-head-screws/2833-SSC-M4-40-A2

https://www.accu.co.uk/en/cap-head-screws/3816-SSCF-M3-5-A2

https://www.accu.co.uk/en/hexagon-nylon-locking-nuts/7946-HNN-M4-A2

https://www.accu.co.uk/en/hexagon-nuts/7888-HPN-M3-A2

https://www.digikey.com/product-detail/en/D2HW-BR213MR/SW728-ND/404511/?itemSeq=321565507

https://www.kjmagnetics.com/proddetail.asp?prod=D73

## Copyright © 2020 Turn Racing, LLC. All rights reserved
