turnracing/turnracing-diy/Turn DIY Files/Turn GT GT3 DIY Files/Turn 3d Shifter DIY Download/CAD Files/Completed Assembly/Turn 3d Shifter Assembly (STEP).step

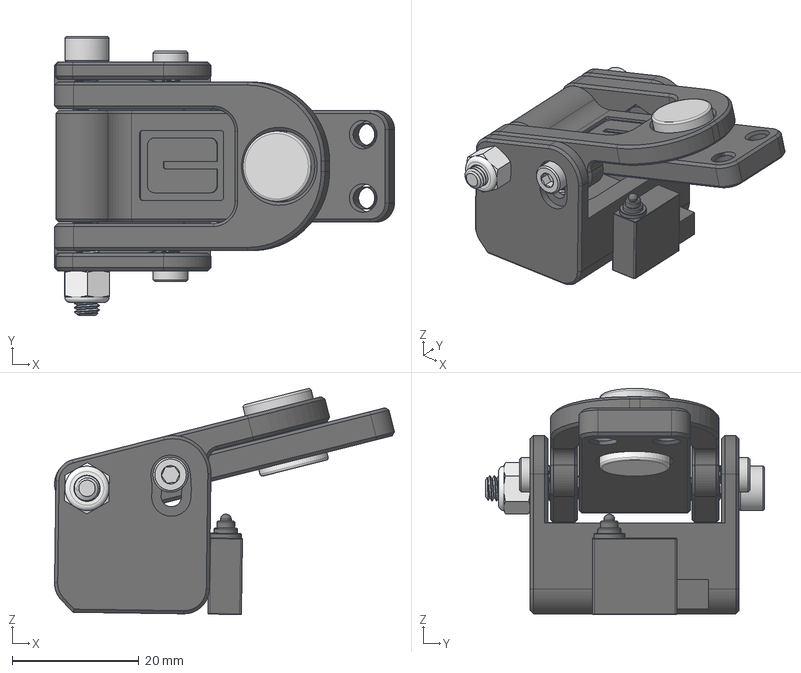
[picture p50: CAD file, 2022-01-05]
Turn DIY Files/Turn GT GT3 DIY Files/Turn 3d Shifter DIY Download/CAD Files/Completed Assembly/Turn 3d Shifter Assembly (STEP).step
53.6 x 44.0 x 35.7 mm
Base Bottom
Base Top
Lever
Top Magnet
Bottom Magnet
D2HW-BR213MR
M4 x 40mm Socket Head Screw
M3 x 5mm Socket Head Screw x 2
M4 Nylon Locknut x 3
M3 Hex Nut x 2
