turnracing/turnracing-diy/Turn DIY Files/Turn 488 Challenge DIY Files/3d Printable Files/Grips/Turn 488 Challenge Grip Right Rear.stl

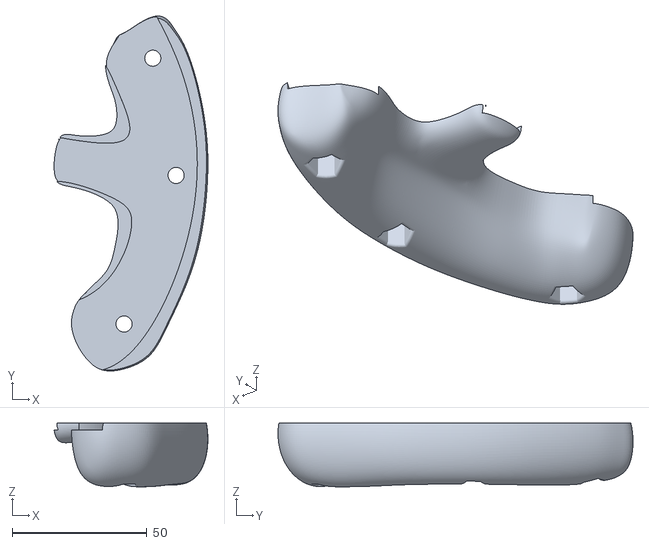
[picture p51: CAD file, 2022-01-05]
Turn DIY Files/Turn 488 Challenge DIY Files/3d Printable Files/Grips/Turn 488 Challenge Grip Right Rear.stl
57.2 x 131.9 x 23.6
