turnracing/turnracing-diy/Turn DIY Files/Turn 488 Challenge DIY Files/CAD Files/.STEP Files/Turn 488 Challenge Right Paddle.step

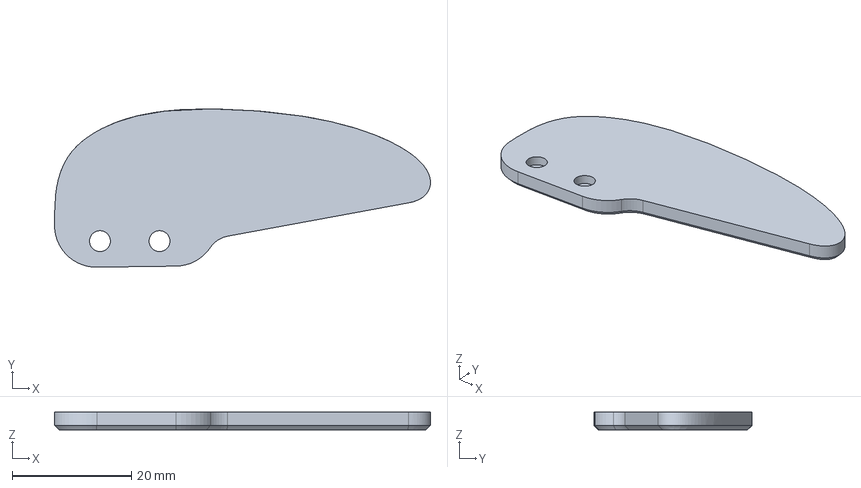
[picture p52: CAD file, 2022-01-05]
Turn DIY Files/Turn 488 Challenge DIY Files/CAD Files/.STEP Files/Turn 488 Challenge Right Paddle.step
63.1 x 26.6 x 3.00 mm
