turnracing/turnracing-diy/Turn DIY Files/Turn 488 Challenge DIY Files/Stickers/Turn 488 Challenge Sticker Cutout Lines DXF.dxf

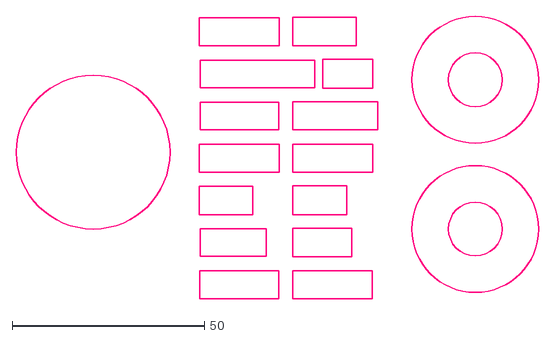
[picture p53: CAD file, 2022-01-05]
Turn DIY Files/Turn 488 Challenge DIY Files/Stickers/Turn 488 Challenge Sticker Cutout Lines DXF.dxf
135.9 x 73.5
