turnracing/turnracing-diy/Turn DIY Files/Turn 911 GT3 Cup DIY Files/CAD Files/.STEP Files/Shifter Paddle Left.step

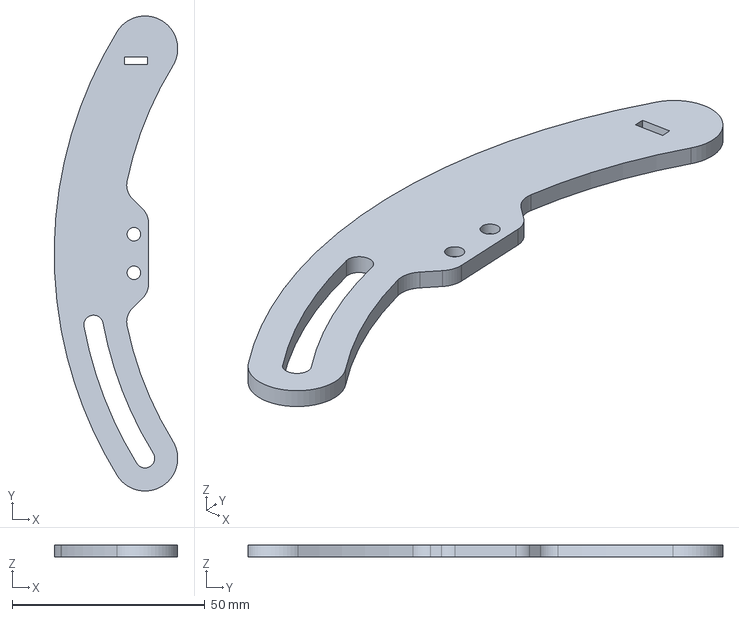
[picture p54: CAD file, 2022-01-05]
Turn DIY Files/Turn 911 GT3 Cup DIY Files/CAD Files/.STEP Files/Shifter Paddle Left.step
32.0 x 123.2 x 3.18 mm
