turnracing/turnracing-diy/Turn DIY Files/Turn 911 GT3 Cup DIY Files/Templates/Turn 911 GT3 Cup Front Plate DXF.dxf

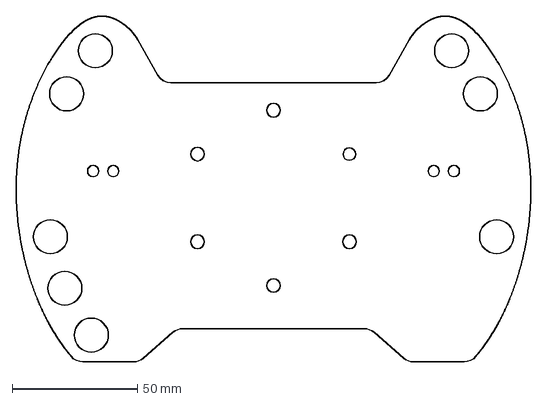
[picture p55: CAD file, 2022-01-05]
Turn DIY Files/Turn 911 GT3 Cup DIY Files/Templates/Turn 911 GT3 Cup Front Plate DXF.dxf
205.5 x 138.1 mm
