turnracing/turnracing-diy/Turn DIY Files/Turn Fiesta WRC DIY Files/CAD Files/.STEP Files/Fiesta WRC Rear Enclosure.step

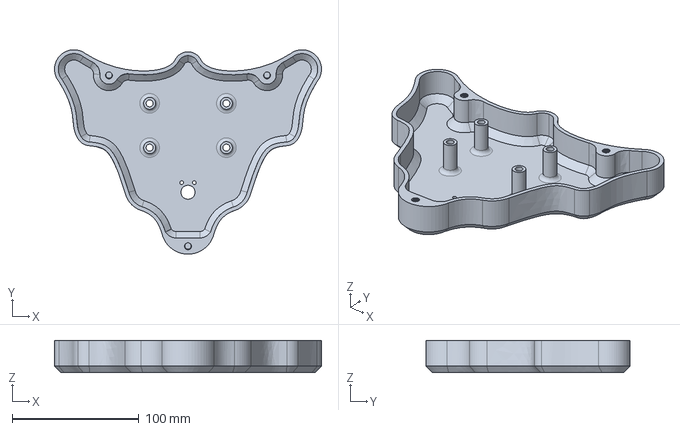
[picture p56: CAD file, 2022-01-05]
Turn DIY Files/Turn Fiesta WRC DIY Files/CAD Files/.STEP Files/Fiesta WRC Rear Enclosure.step
210.9 x 161.5 x 25.4 mm
