turnracing/turnracing-diy/Turn DIY Files/Turn GT GT3 DIY Files/3d Printable Files/GT Front Plate.stl

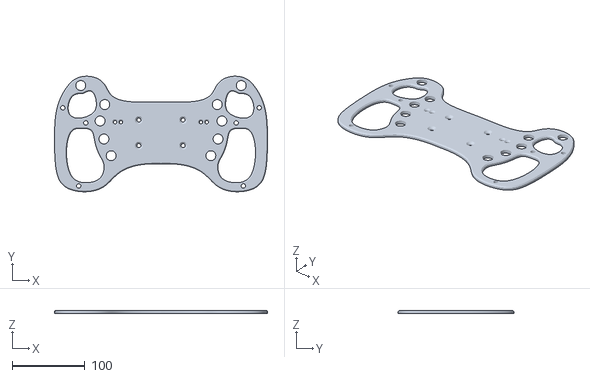
[picture p57: CAD file, 2022-01-05]
Turn DIY Files/Turn GT GT3 DIY Files/3d Printable Files/GT Front Plate.stl
292.0 x 158.4 x 4.50
