turnracing/turnracing-diy/Turn DIY Files/Turn GT GT3 DIY Files/CAD Files/.STEP Files/Grips/Right Grip front.step

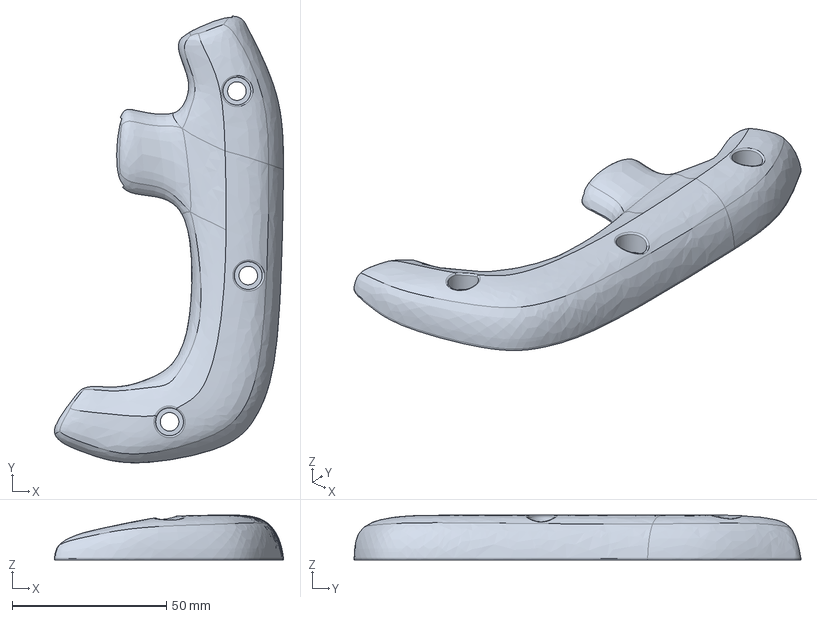
[picture p58: CAD file, 2022-01-05]
Turn DIY Files/Turn GT GT3 DIY Files/CAD Files/.STEP Files/Grips/Right Grip front.step
74.1 x 144.6 x 14.5 mm
