turnracing/turnracing-diy/Turn DIY Files/Turn GT GT3 DIY Files/Turn 3d Shifter DIY Download/CAD Files/.STEP Files/Lever.step

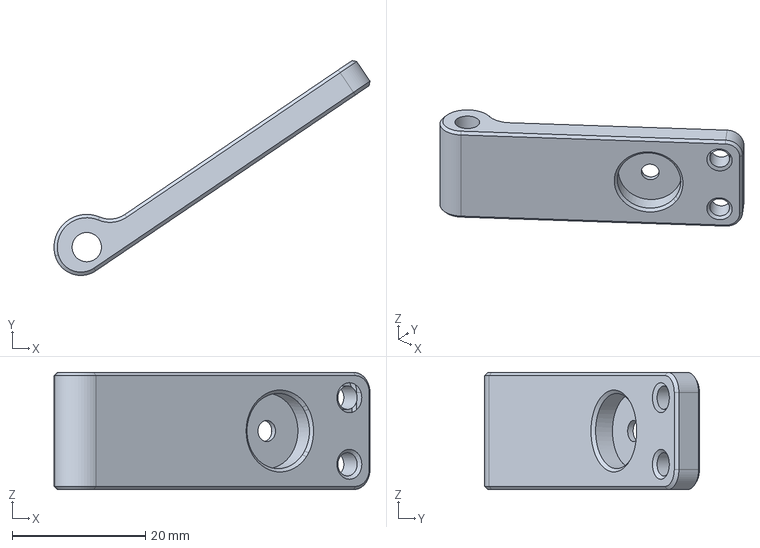
[picture p59: CAD file, 2022-01-05]
Turn DIY Files/Turn GT GT3 DIY Files/Turn 3d Shifter DIY Download/CAD Files/.STEP Files/Lever.step
47.4 x 32.3 x 17.6 mm
