turnracing/turnracing-diy/Turn DIY Files/Turn GTE DIY Files/3d Printable Files/Button Inserts/Left Rear Button Cover.stl

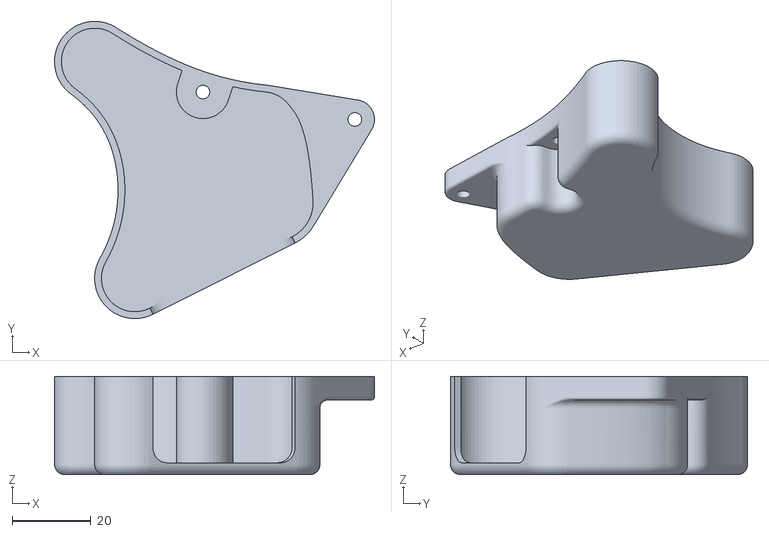
[picture p60: CAD file, 2022-01-05]
Turn DIY Files/Turn GTE DIY Files/3d Printable Files/Button Inserts/Left Rear Button Cover.stl
81.5 x 75.7 x 25.0
