turnracing/turnracing-diy/Turn DIY Files/Turn GTE DIY Files/3d Printable Files/Grips/Grip Left Front.stl

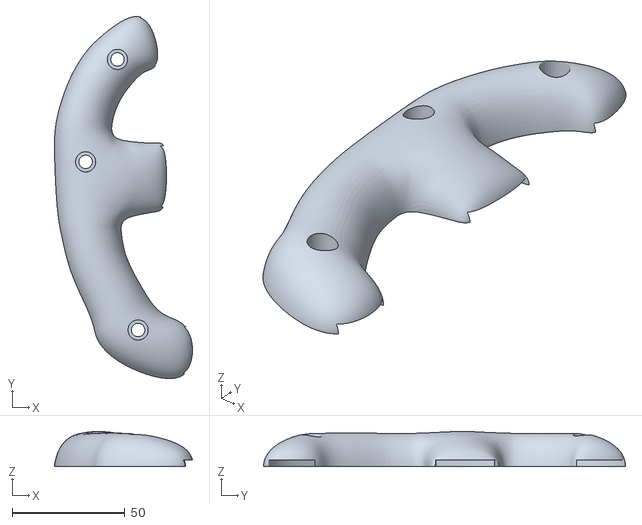
[picture p61: CAD file, 2022-01-05]
Turn DIY Files/Turn GTE DIY Files/3d Printable Files/Grips/Grip Left Front.stl
61.3 x 160.8 x 15.6
