turnracing/turnracing-diy/Turn DIY Files/Turn GTE DIY Files/3d Printable Files/Plates/Hub Rear Plate.stl

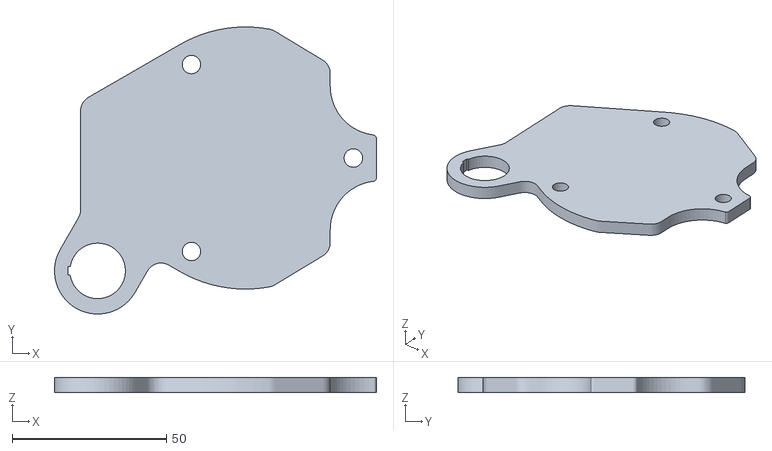
[picture p62: CAD file, 2022-01-05]
Turn DIY Files/Turn GTE DIY Files/3d Printable Files/Plates/Hub Rear Plate.stl
104.4 x 93.1 x 4.77
