turnracing/turnracing-diy/Turn DIY Files/Turn GTE DIY Files/3d Printable Files/Rotary Encoder Knob.stl

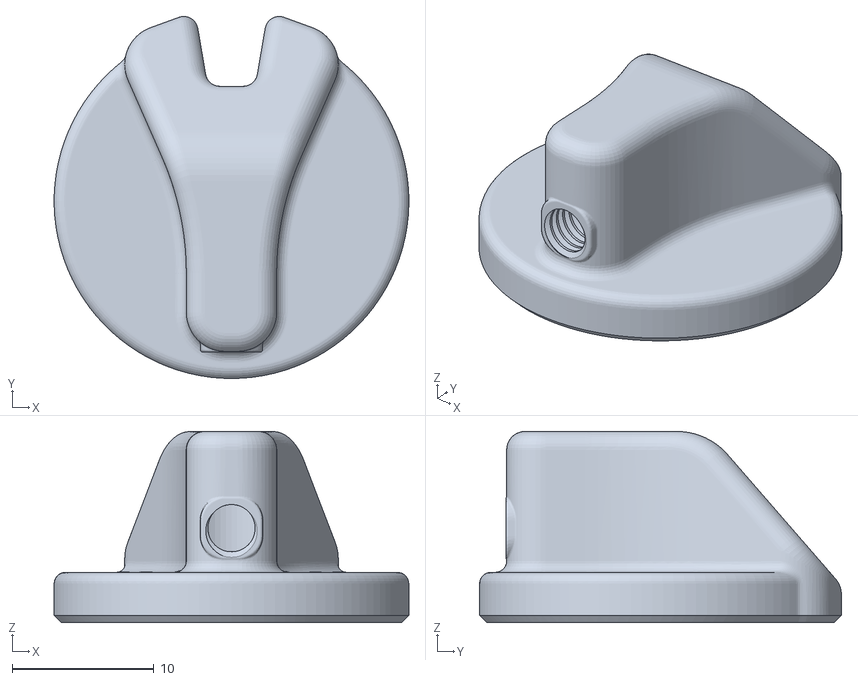
[picture p63: CAD file, 2022-01-05]
Turn DIY Files/Turn GTE DIY Files/3d Printable Files/Rotary Encoder Knob.stl
25.0 x 25.5 x 13.5
