turnracing/turnracing-diy/Turn DIY Files/Turn GTE DIY Files/3d Printable Files/Spacers/Hub Spacer.stl

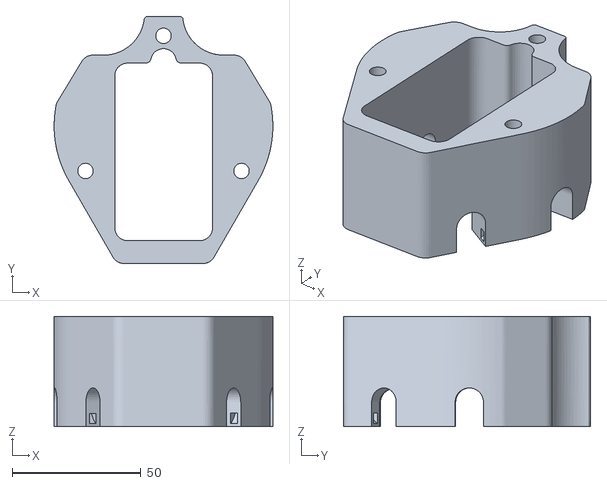
[picture p64: CAD file, 2022-01-05]
Turn DIY Files/Turn GTE DIY Files/3d Printable Files/Spacers/Hub Spacer.stl
85.0 x 96.0 x 42.8
