turnracing/turnracing-diy/Turn DIY Files/Turn GTE DIY Files/CAD Files/.STEP Files/Front Plate.step

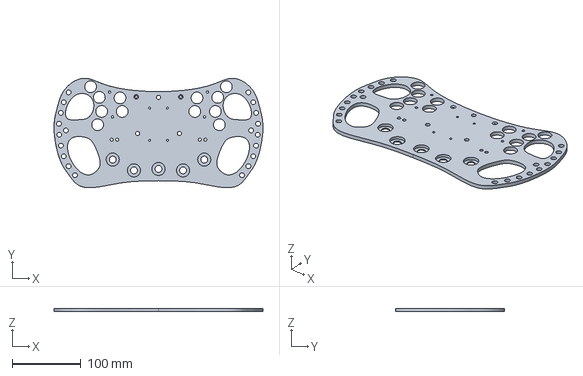
[picture p65: CAD file, 2022-01-05]
Turn DIY Files/Turn GTE DIY Files/CAD Files/.STEP Files/Front Plate.step
303.4 x 158.9 x 4.77 mm
