turnracing/turnracing-diy/Turn DIY Files/Turn GTE DIY Files/Stickers/Turn GTE Sticker Cutout Lines DXF.dxf

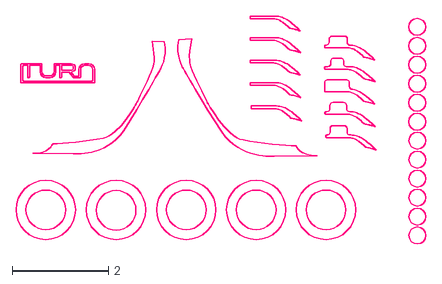
[picture p66: CAD file, 2022-01-05]
Turn DIY Files/Turn GTE DIY Files/Stickers/Turn GTE Sticker Cutout Lines DXF.dxf
8.53 x 4.75
