turnracing/turnracing-diy/Turn DIY Files/Turn GTE DIY Files/Templates/Front Plate DXF_303.5mm Width.dxf

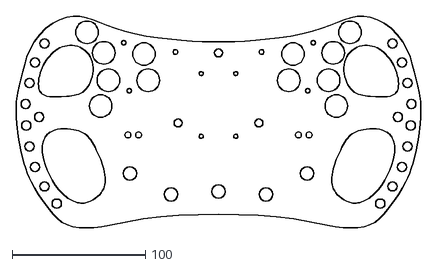
[picture p67: CAD file, 2022-01-05]
Turn DIY Files/Turn GTE DIY Files/Templates/Front Plate DXF_303.5mm Width.dxf
303.5 x 158.8
