turnracing/turnracing-diy/Turn DIY Files/Turn R8 LMS DIY Files/3d Printable Files/Rear Enclosure.stl

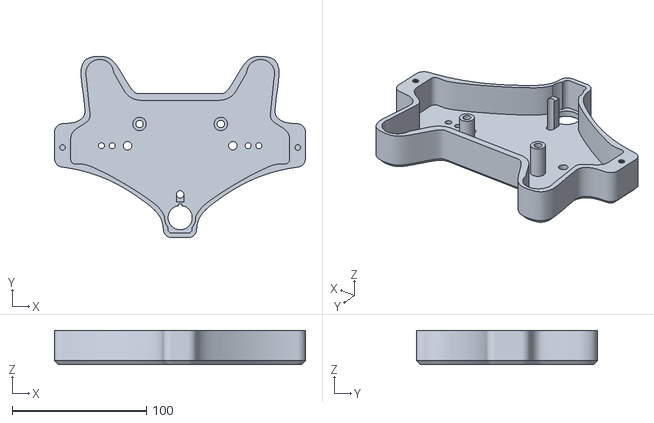
[picture p68: CAD file, 2022-01-05]
Turn DIY Files/Turn R8 LMS DIY Files/3d Printable Files/Rear Enclosure.stl
187.2 x 135.3 x 25.4
