turnracing/turnracing-diy/Turn DIY Files/Turn R8 LMS DIY Files/CAD Files/.STEP Files/Button Guard.step

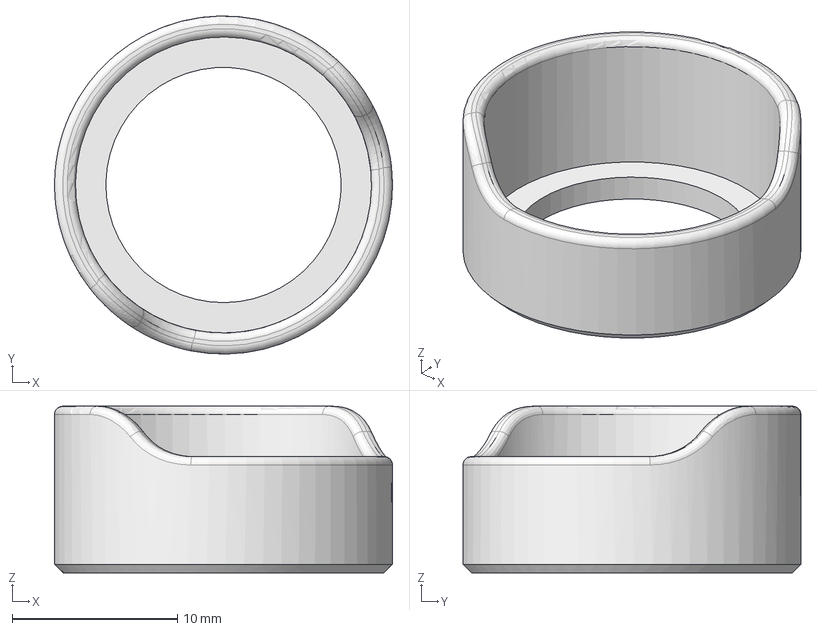
[picture p69: CAD file, 2022-01-05]
Turn DIY Files/Turn R8 LMS DIY Files/CAD Files/.STEP Files/Button Guard.step
20.4 x 20.4 x 10.1 mm
