turnracing/turnracing-diy/Turn DIY Files/Turn R8 LMS DIY Files/DXF Template/Turn R8 Plate Template DXFv2.dxf

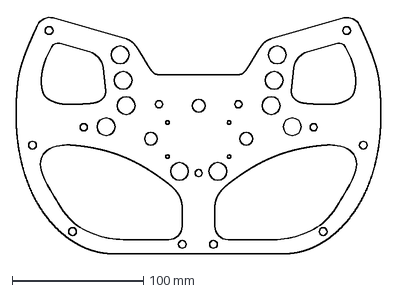
[picture p70: CAD file, 2022-01-05]
Turn DIY Files/Turn R8 LMS DIY Files/DXF Template/Turn R8 Plate Template DXFv2.dxf
278.4 x 181.3 mm
