turnracing/turnracing-diy/Turn DIY Files/Turn R8 LMS DIY Files/Stickers/Turn R8 Sticker Cutout Lines DXF.dxf

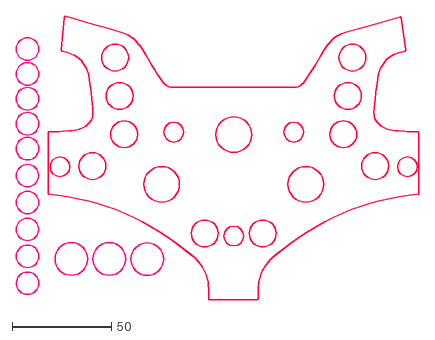
[picture p71: CAD file, 2022-01-05]
Turn DIY Files/Turn R8 LMS DIY Files/Stickers/Turn R8 Sticker Cutout Lines DXF.dxf
203.3 x 143.2
