turnracing/turnracing-diy/Turn DIY Files/Turn RSR-17 DIY Files/CAD Files/.STEP Files/Right Grip Back.step

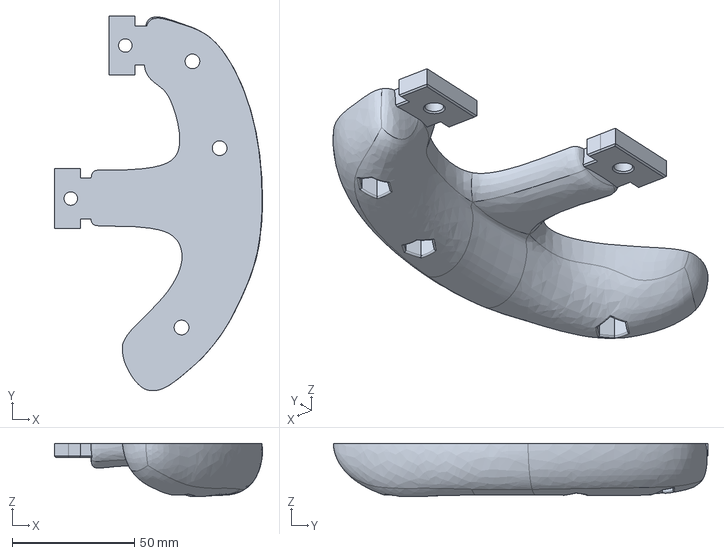
[picture p72: CAD file, 2022-01-05]
Turn DIY Files/Turn RSR-17 DIY Files/CAD Files/.STEP Files/Right Grip Back.step
85.0 x 153.0 x 21.8 mm
