turnracing/turnracing-diy/Turn DIY Files/Turn 488 Challenge DIY Files/3d Printable Files/Grips/Turn 488 Challenge Grip Left Front.stl

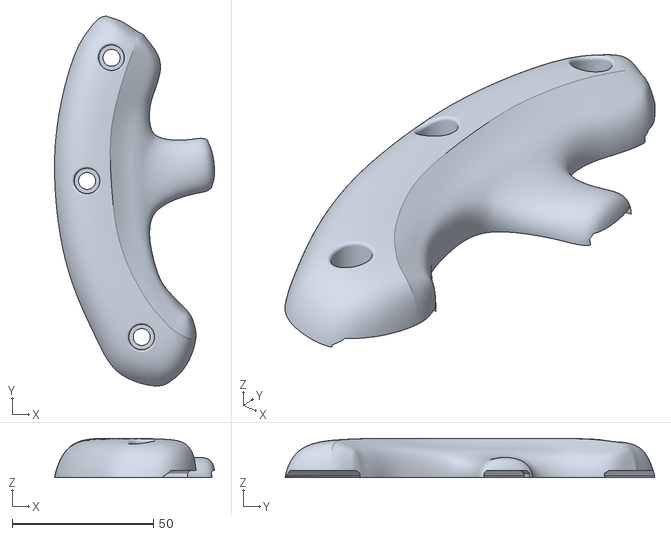
[picture p73: CAD file, 2022-01-05]
Turn DIY Files/Turn 488 Challenge DIY Files/3d Printable Files/Grips/Turn 488 Challenge Grip Left Front.stl
56.6 x 130.9 x 13.8
