turnracing/turnracing-diy/Turn DIY Files/Turn 488 Challenge DIY Files/CAD Files/.STEP Files/Turn 488 Challenge Front Plate.step

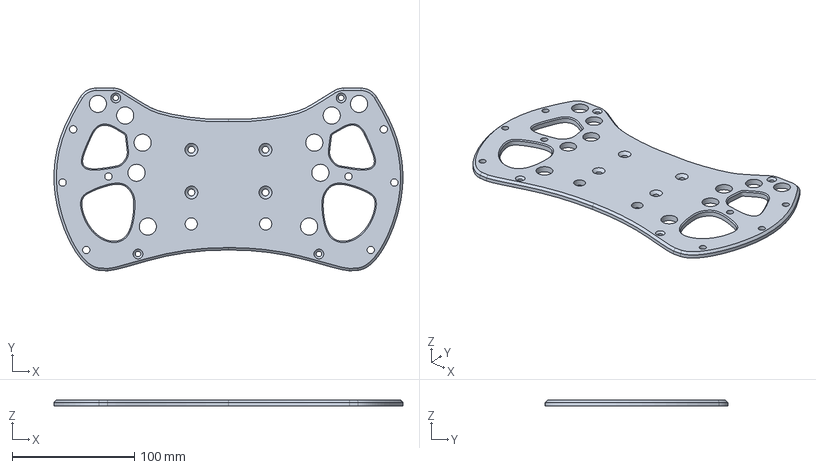
[picture p74: CAD file, 2022-01-05]
Turn DIY Files/Turn 488 Challenge DIY Files/CAD Files/.STEP Files/Turn 488 Challenge Front Plate.step
285.8 x 149.6 x 5.00 mm
