turnracing/turnracing-diy/Turn DIY Files/Turn 911 GT3 Cup DIY Files/CAD Files/.STEP Files/Hub.step

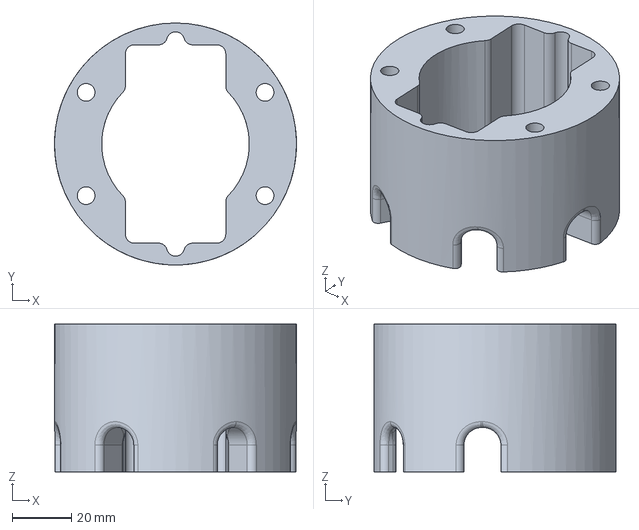
[picture p75: CAD file, 2022-01-05]
Turn DIY Files/Turn 911 GT3 Cup DIY Files/CAD Files/.STEP Files/Hub.step
82.0 x 82.0 x 50.0 mm
