turnracing/turnracing-diy/Turn DIY Files/Turn Fiesta WRC DIY Files/CAD Files/.STEP Files/Ascher Rally Shifter Bracket.step

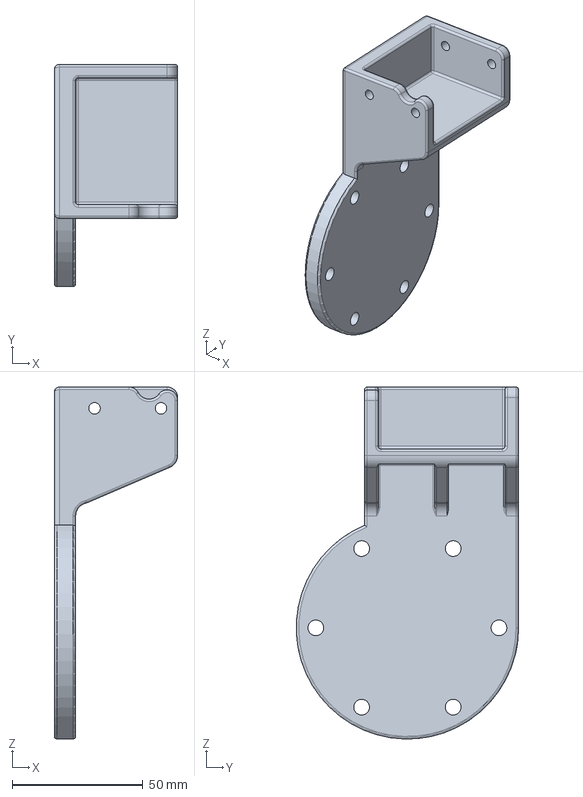
[picture p76: CAD file, 2022-01-05]
Turn DIY Files/Turn Fiesta WRC DIY Files/CAD Files/.STEP Files/Ascher Rally Shifter Bracket.step
47.2 x 84.9 x 134.5 mm
