turnracing/turnracing-diy/Turn DIY Files/Turn GT GT3 DIY Files/3d Printable Files/Shifter Right Spacer.stl

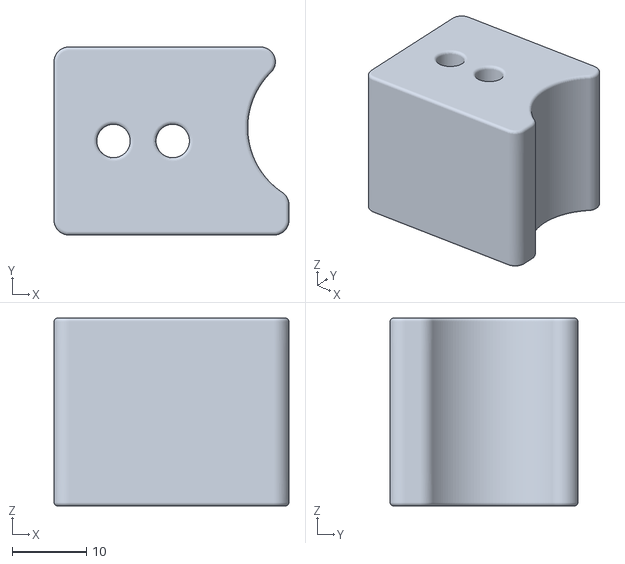
[picture p77: CAD file, 2022-01-05]
Turn DIY Files/Turn GT GT3 DIY Files/3d Printable Files/Shifter Right Spacer.stl
31.8 x 25.4 x 25.4
