turnracing/turnracing-diy/Turn DIY Files/Turn GT GT3 DIY Files/Turn 3d Shifter DIY Download/CAD Files/.STEP Files/Base Bottom.step

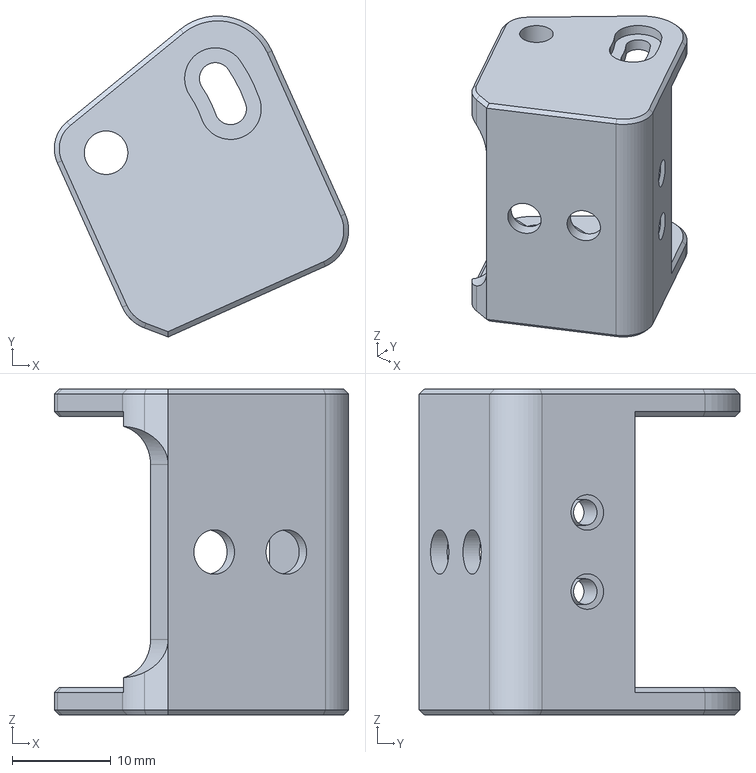
[picture p78: CAD file, 2022-01-05]
Turn DIY Files/Turn GT GT3 DIY Files/Turn 3d Shifter DIY Download/CAD Files/.STEP Files/Base Bottom.step
29.8 x 32.5 x 32.9 mm
