turnracing/turnracing-diy/Turn DIY Files/Turn GTE DIY Files/3d Printable Files/Spacers/3 inch 70mm Spacer.stl

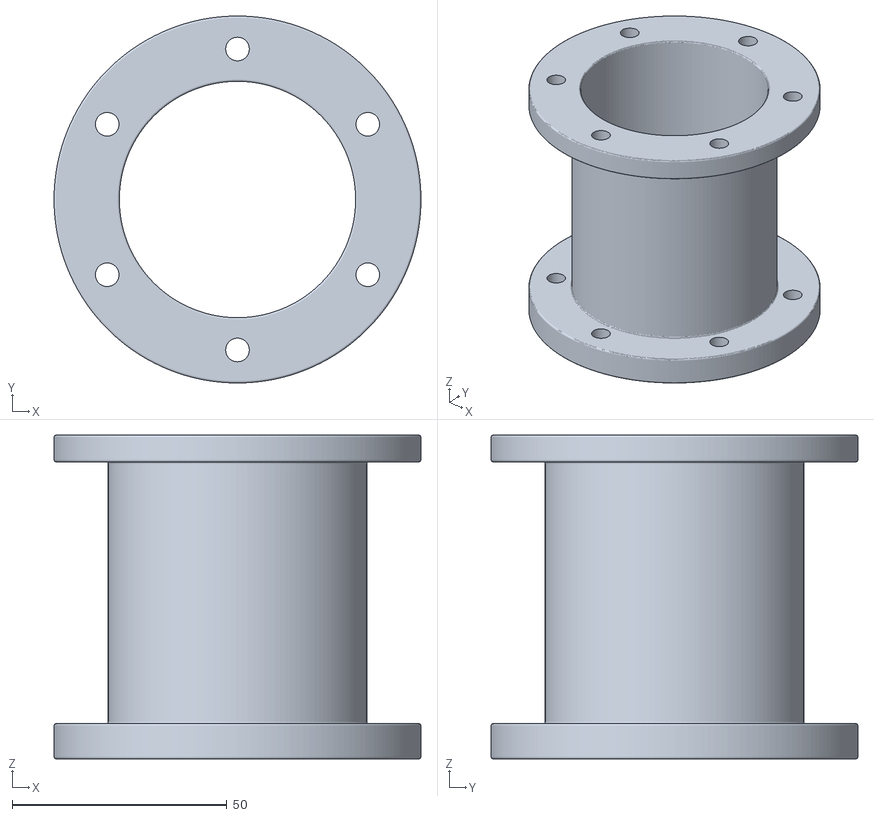
[picture p79: CAD file, 2022-01-05]
Turn DIY Files/Turn GTE DIY Files/3d Printable Files/Spacers/3 inch 70mm Spacer.stl
85.4 x 85.4 x 75.3
