turnracing/turnracing-diy/Turn DIY Files/Turn GTE DIY Files/CAD Files/.STEP Files/Shifter Paddle.step

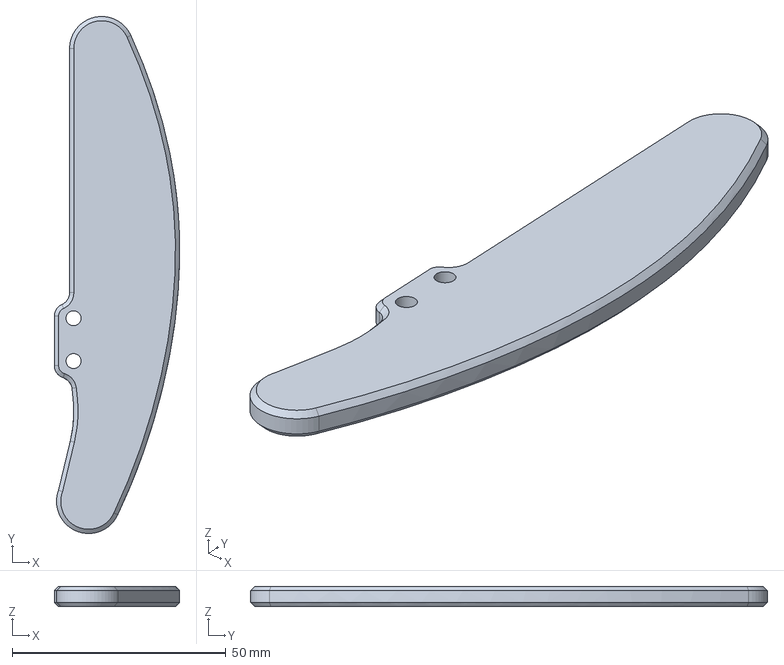
[picture p80: CAD file, 2022-01-05]
Turn DIY Files/Turn GTE DIY Files/CAD Files/.STEP Files/Shifter Paddle.step
29.3 x 120.8 x 4.77 mm
