turnracing/turnracing-diy/Turn DIY Files/Turn GTE DIY Files/Templates/Rear Plate DXF_104.4mm Width.dxf

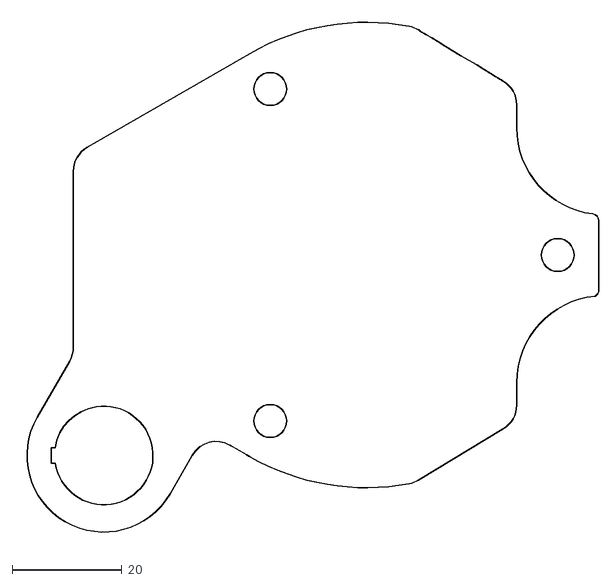
[picture p81: CAD file, 2022-01-05]
Turn DIY Files/Turn GTE DIY Files/Templates/Rear Plate DXF_104.4mm Width.dxf
106.4 x 96.2
