turnracing/turnracing-diy/Turn DIY Files/Turn R8 LMS DIY Files/CAD Files/.STEP Files/R8 Right Paddle.step

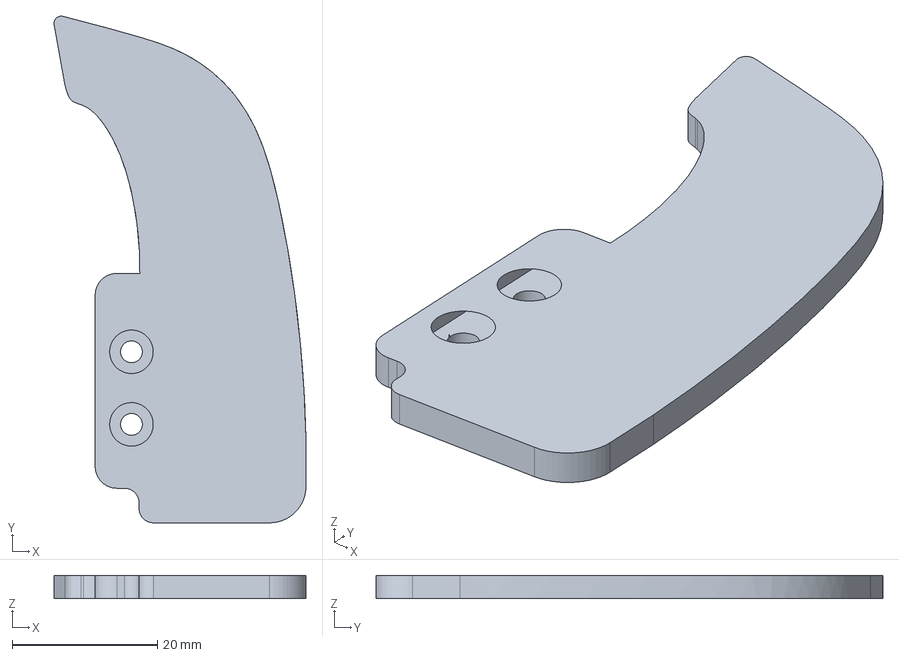
[picture p82: CAD file, 2022-01-05]
Turn DIY Files/Turn R8 LMS DIY Files/CAD Files/.STEP Files/R8 Right Paddle.step
34.7 x 69.8 x 3.17 mm
