turnracing/turnracing-diy/Turn DIY Files/Turn RSR-17 DIY Files/CAD Files/.STEP Files/Shifter Right Paddle.step

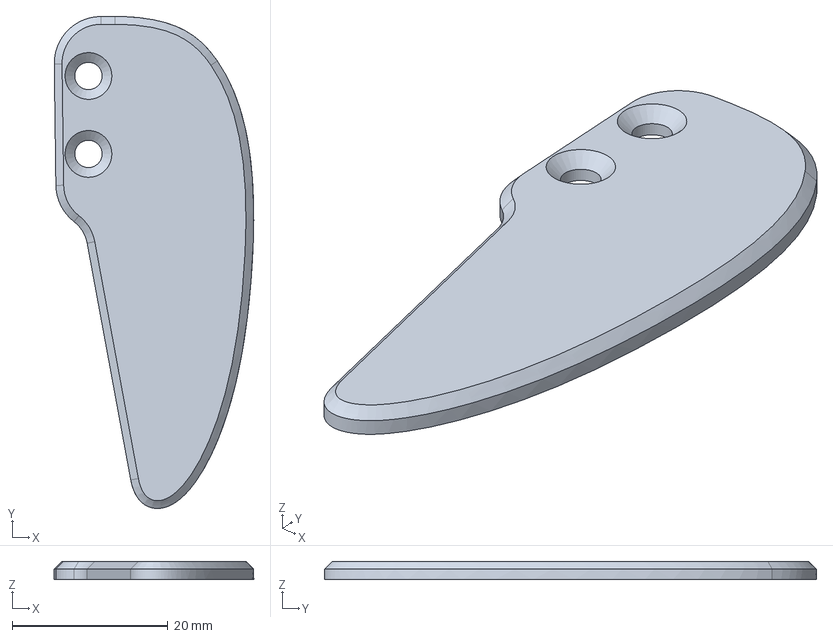
[picture p83: CAD file, 2022-01-05]
Turn DIY Files/Turn RSR-17 DIY Files/CAD Files/.STEP Files/Shifter Right Paddle.step
25.6 x 63.1 x 2.36 mm
