turnracing/turnracing-diy/Turn DIY Files/Turn 911 GT3 Cup DIY Files/CAD Files/.STEP Files/Rear Plate.step

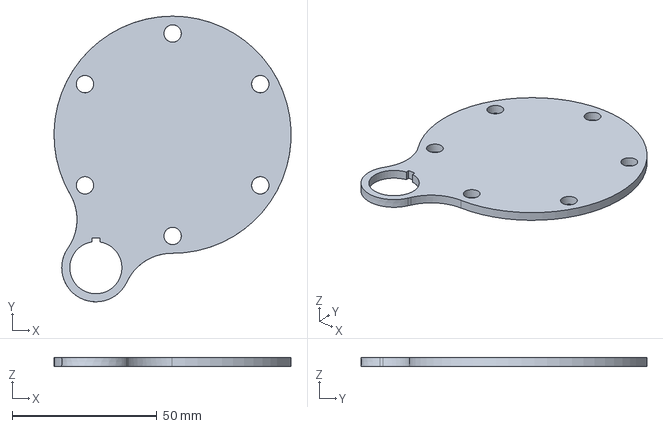
[picture p84: CAD file, 2022-01-05]
Turn DIY Files/Turn 911 GT3 Cup DIY Files/CAD Files/.STEP Files/Rear Plate.step
81.9 x 98.8 x 3.18 mm
