turnracing/turnracing-diy/Turn DIY Files/Turn Fiesta WRC DIY Files/CAD Files/.STEP Files/Fiesta WRC Front Plate.step

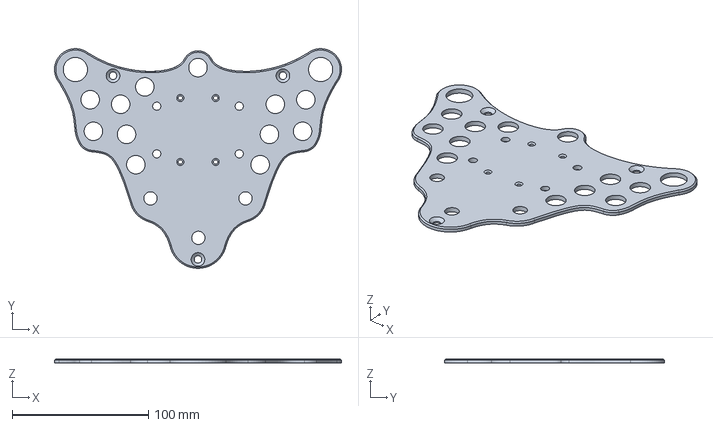
[picture p85: CAD file, 2022-01-05]
Turn DIY Files/Turn Fiesta WRC DIY Files/CAD Files/.STEP Files/Fiesta WRC Front Plate.step
210.9 x 161.5 x 3.18 mm
