turnracing/turnracing-diy/Turn DIY Files/Turn GT GT3 DIY Files/CAD Files/.STEP Files/Grips/Left Grip Back.step

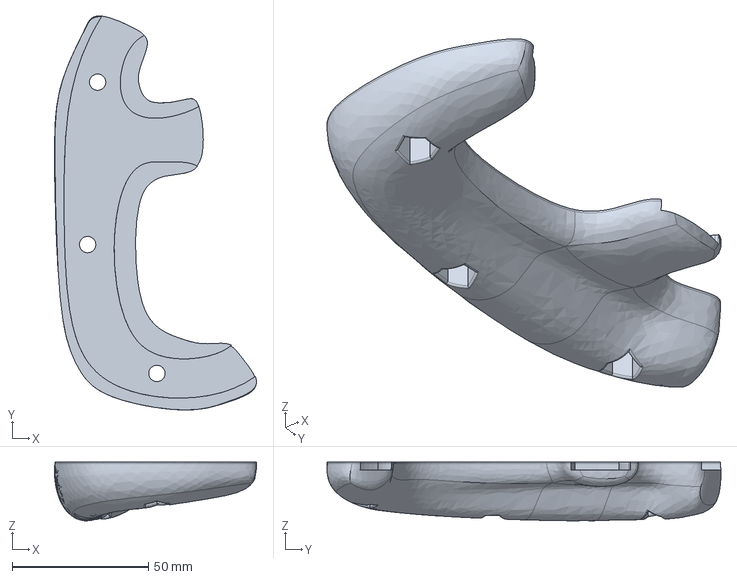
[picture p86: CAD file, 2022-01-05]
Turn DIY Files/Turn GT GT3 DIY Files/CAD Files/.STEP Files/Grips/Left Grip Back.step
74.3 x 144.8 x 21.6 mm
