turnracing/turnracing-diy/Turn DIY Files/Turn GT GT3 DIY Files/Turn 3d Shifter DIY Download/CAD Files/.STEP Files/Base Top.step

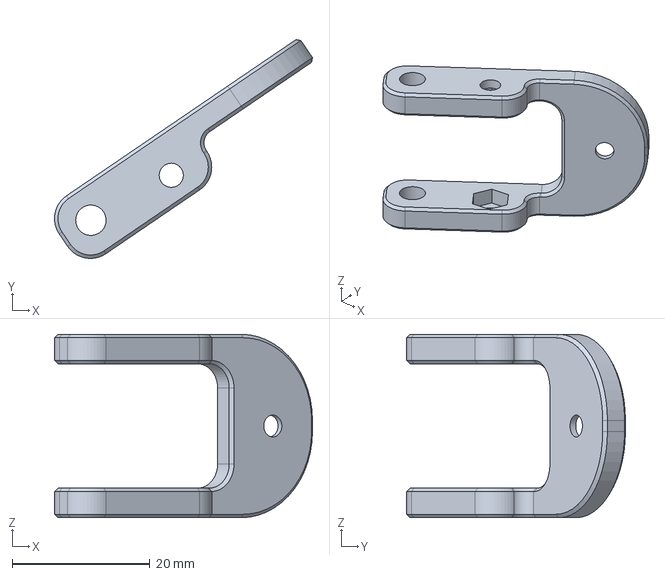
[picture p87: CAD file, 2022-01-05]
Turn DIY Files/Turn GT GT3 DIY Files/Turn 3d Shifter DIY Download/CAD Files/.STEP Files/Base Top.step
37.4 x 31.7 x 26.6 mm
