turnracing/turnracing-diy/Turn DIY Files/Turn GTE DIY Files/3d Printable Files/Button Inserts/Left Button Insert.stl

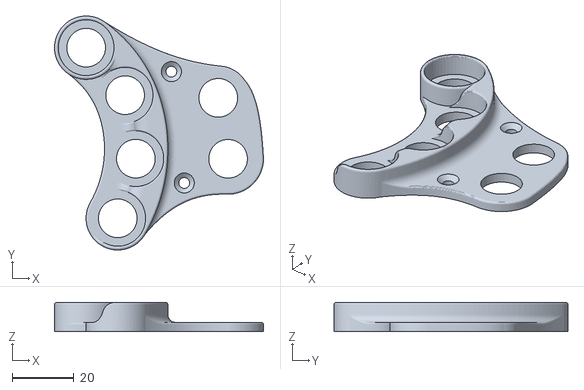
[picture p88: CAD file, 2022-01-05]
Turn DIY Files/Turn GTE DIY Files/3d Printable Files/Button Inserts/Left Button Insert.stl
67.6 x 75.7 x 9.50
