turnracing/turnracing-diy/Turn DIY Files/Turn GTE DIY Files/3d Printable Files/Grips/Grip Left Rear.stl

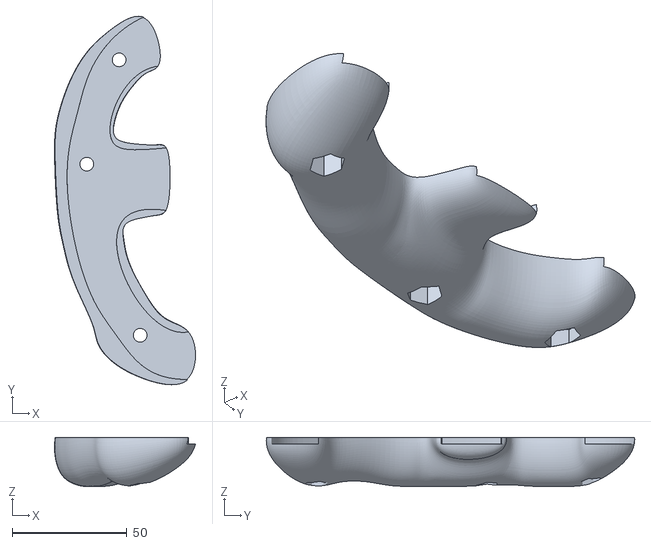
[picture p89: CAD file, 2022-01-05]
Turn DIY Files/Turn GTE DIY Files/3d Printable Files/Grips/Grip Left Rear.stl
61.5 x 160.9 x 21.5
