turnracing/turnracing-diy/Turn DIY Files/Turn GTE DIY Files/3d Printable Files/Spacers/Shifter Spacer.stl

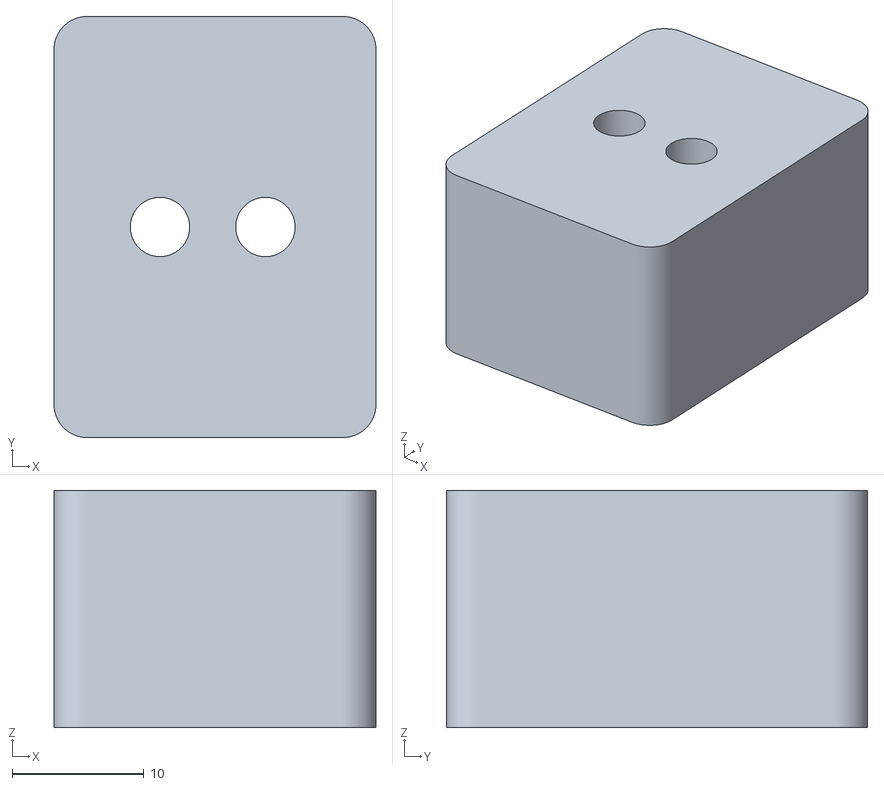
[picture p90: CAD file, 2022-01-05]
Turn DIY Files/Turn GTE DIY Files/3d Printable Files/Spacers/Shifter Spacer.stl
24.4 x 31.9 x 18.0
