turnracing/turnracing-diy/Turn DIY Files/Turn GTE DIY Files/Templates/Left Grip Suede Template DXF.dxf

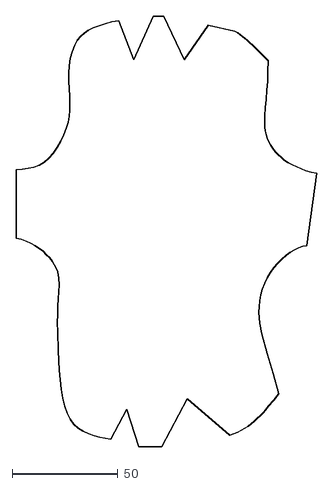
[picture p91: CAD file, 2022-01-05]
Turn DIY Files/Turn GTE DIY Files/Templates/Left Grip Suede Template DXF.dxf
142.0 x 203.8
