turnracing/turnracing-diy/Turn DIY Files/Turn R8 LMS DIY Files/CAD Files/.STEP Files/Right Front Grip.step

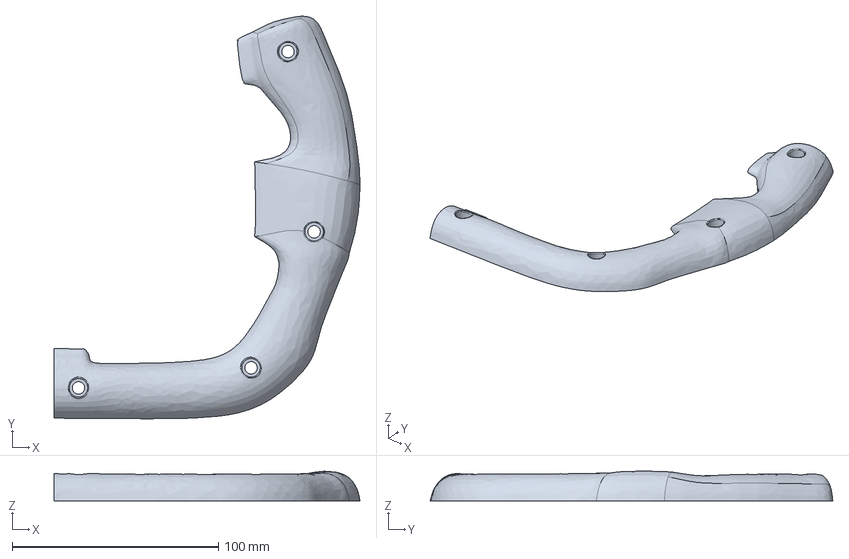
[picture p92: CAD file, 2022-01-05]
Turn DIY Files/Turn R8 LMS DIY Files/CAD Files/.STEP Files/Right Front Grip.step
148.5 x 195.3 x 14.3 mm
