turnracing/turnracing-diy/Turn DIY Files/Turn 488 Challenge DIY Files/CAD Files/.STEP Files/Turn 488 Challenge Encoder Knob.step

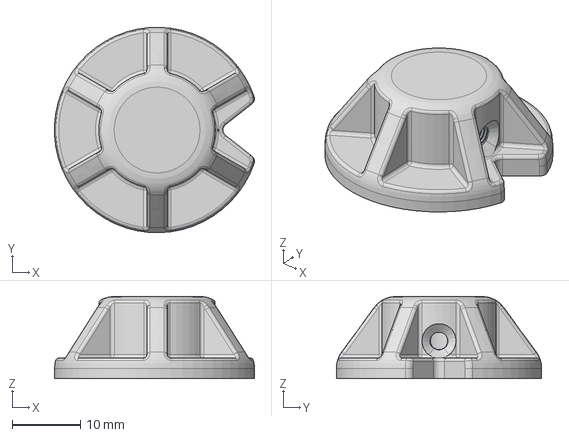
[picture p93: CAD file, 2022-01-05]
Turn DIY Files/Turn 488 Challenge DIY Files/CAD Files/.STEP Files/Turn 488 Challenge Encoder Knob.step
29.2 x 30.0 x 12.0 mm
