turnracing/turnracing-diy/Turn DIY Files/Turn Fiesta WRC DIY Files/CAD Files/.STEP Files/1 Inch Spacer.step

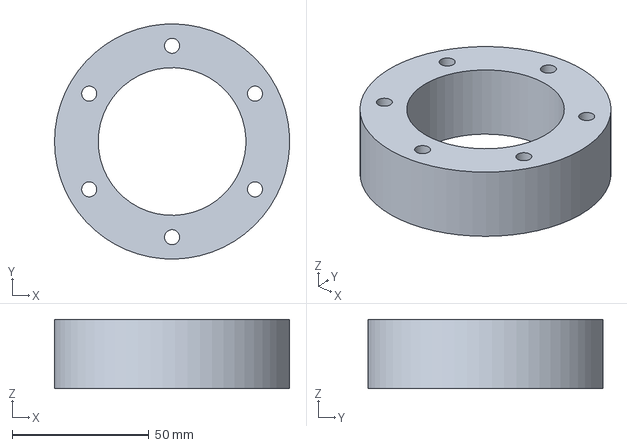
[picture p95: CAD file, 2022-01-05]
Turn DIY Files/Turn Fiesta WRC DIY Files/CAD Files/.STEP Files/1 Inch Spacer.step
85.9 x 86.0 x 25.4 mm
