turnracing/turnracing-diy/Turn DIY Files/Turn R8 LMS DIY Files/CAD Files/.STEP Files/Right Back Grip.step

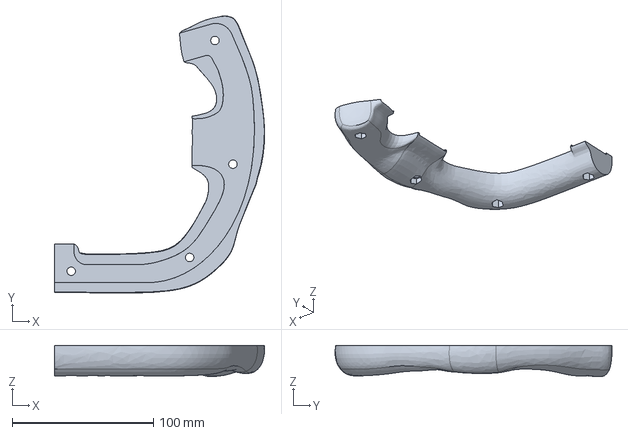
[picture p97: CAD file, 2022-01-05]
Turn DIY Files/Turn R8 LMS DIY Files/CAD Files/.STEP Files/Right Back Grip.step
148.6 x 195.9 x 22.2 mm
