turnracing/turnracing-diy/Turn DIY Files/Turn RSR-17 DIY Files/CAD Files/.STEP Files/Shifter Base.step

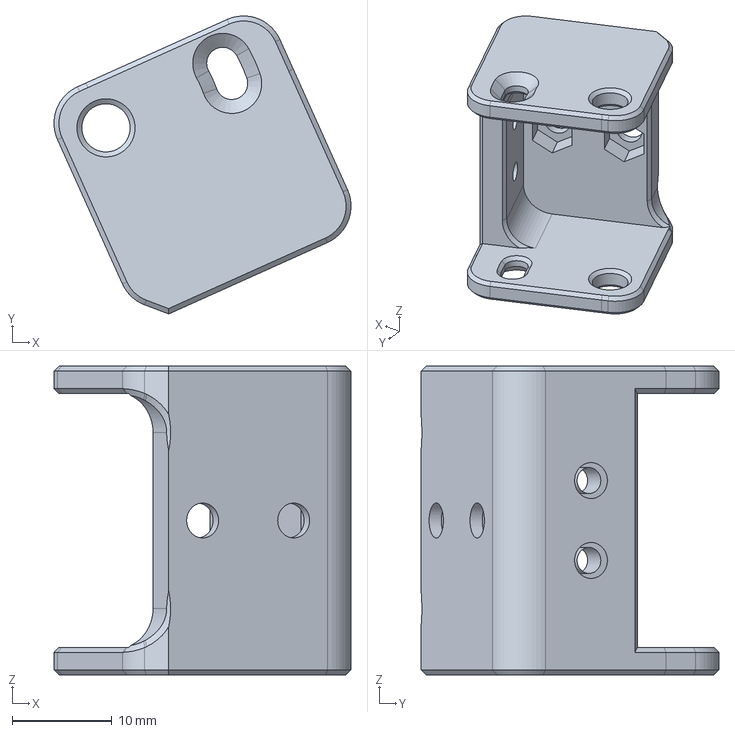
[picture p98: CAD file, 2022-01-05]
Turn DIY Files/Turn RSR-17 DIY Files/CAD Files/.STEP Files/Shifter Base.step
29.7 x 29.8 x 30.9 mm
