turnracing/turnracing-diy/Turn DIY Files/Turn 488 Challenge DIY Files/CAD Files/.STEP Files/Turn 488 Challenge Rear Enclosure.step

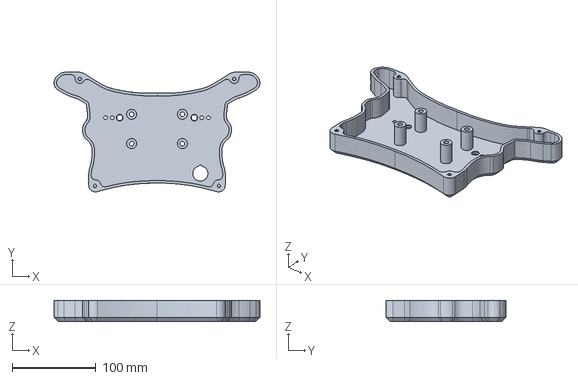
[picture p99: CAD file, 2022-01-05]
Turn DIY Files/Turn 488 Challenge DIY Files/CAD Files/.STEP Files/Turn 488 Challenge Rear Enclosure.step
246.1 x 143.2 x 25.4 mm
