turnracing/turnracing-diy/Turn DIY Files/Turn 911 GT3 Cup DIY Files/CAD Files/.STEP Files/Turn 911 GT3 Cup Front Plate.step

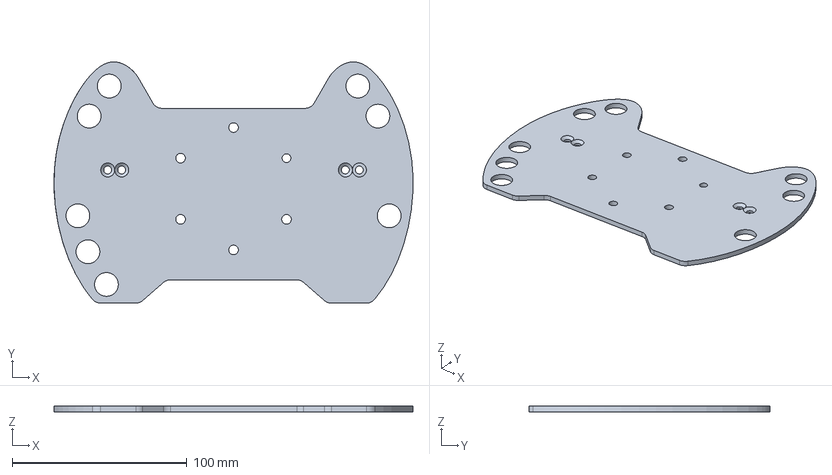
[picture p100: CAD file, 2022-01-05]
Turn DIY Files/Turn 911 GT3 Cup DIY Files/CAD Files/.STEP Files/Turn 911 GT3 Cup Front Plate.step
205.4 x 138.1 x 3.18 mm
