turnracing/turnracing-diy/Turn DIY Files/Turn RSR-17 DIY Files/CAD Files/.STEP Files/Rear Enclosure.step

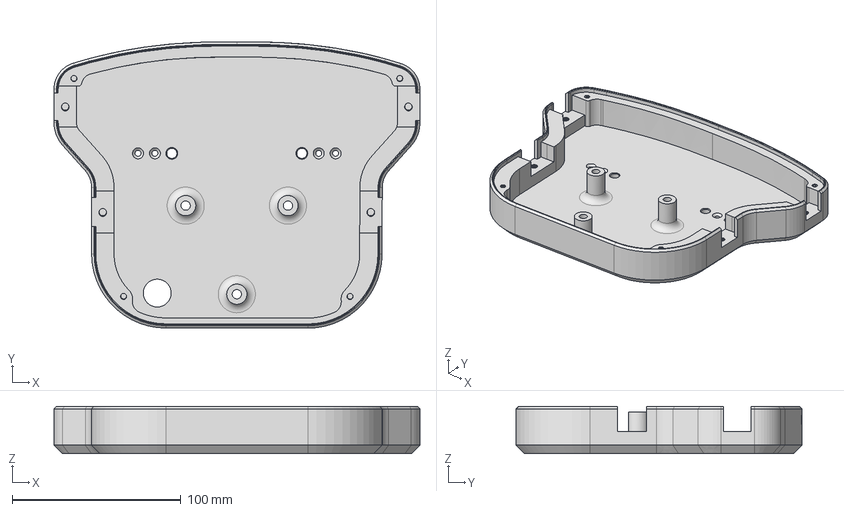
[picture p101: CAD file, 2022-01-05]
Turn DIY Files/Turn RSR-17 DIY Files/CAD Files/.STEP Files/Rear Enclosure.step
216.9 x 169.7 x 28.0 mm
