turnracing/turnracing-diy/Turn DIY Files/Turn RSR-17 DIY Files/CAD Files/.STEP Files/Left Grip Front.step

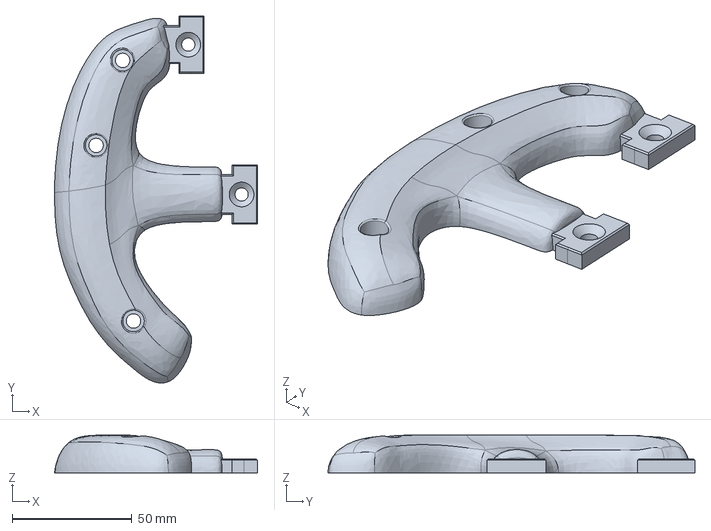
[picture p102: CAD file, 2022-01-05]
Turn DIY Files/Turn RSR-17 DIY Files/CAD Files/.STEP Files/Left Grip Front.step
84.8 x 153.1 x 15.7 mm
