turnracing/turnracing-diy/Turn DIY Files/Turn R8 LMS DIY Files/CAD Files/.STEP Files/Front Plate.step

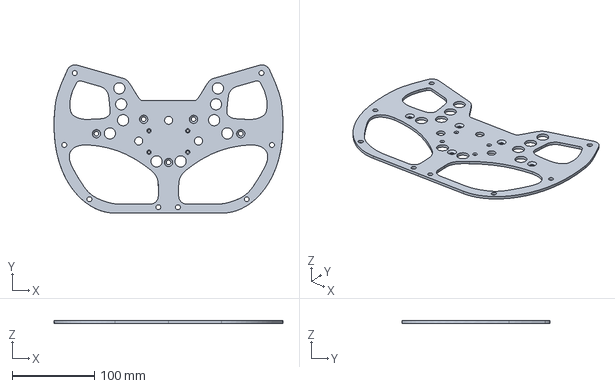
[picture p103: CAD file, 2022-01-05]
Turn DIY Files/Turn R8 LMS DIY Files/CAD Files/.STEP Files/Front Plate.step
278.4 x 180.4 x 3.17 mm
