turnracing/turnracing-diy/Turn DIY Files/Turn RSR-17 DIY Files/CAD Files/.STEP Files/Shifter Base Top.step

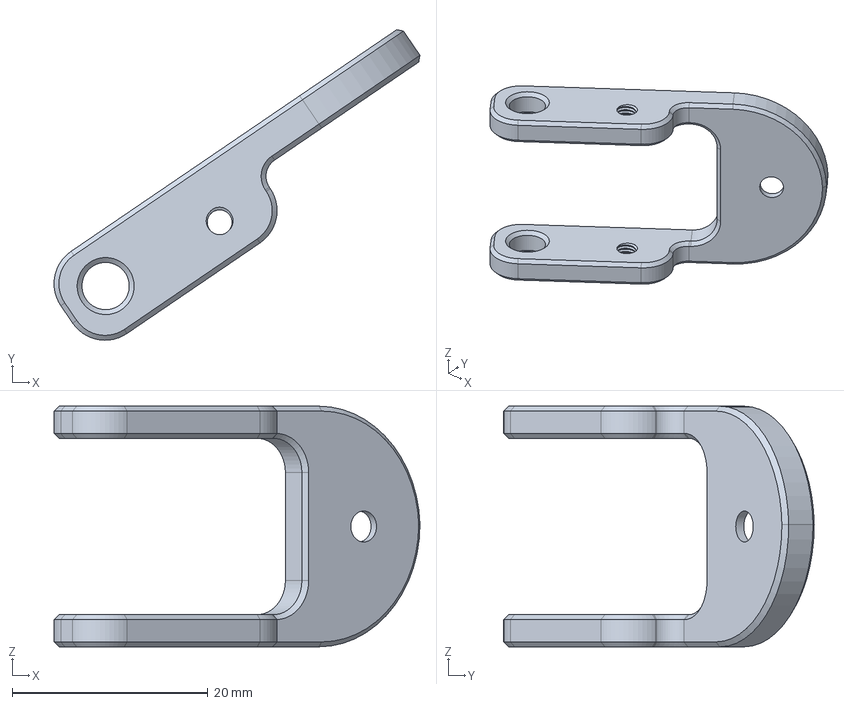
[picture p106: CAD file, 2022-01-05]
Turn DIY Files/Turn RSR-17 DIY Files/CAD Files/.STEP Files/Shifter Base Top.step
37.4 x 31.7 x 24.6 mm
