turnracing/turnracing-diy/Turn DIY Files/Turn RSR-17 DIY Files/CAD Files/.STEP Files/Rotary Encoder Knob.step

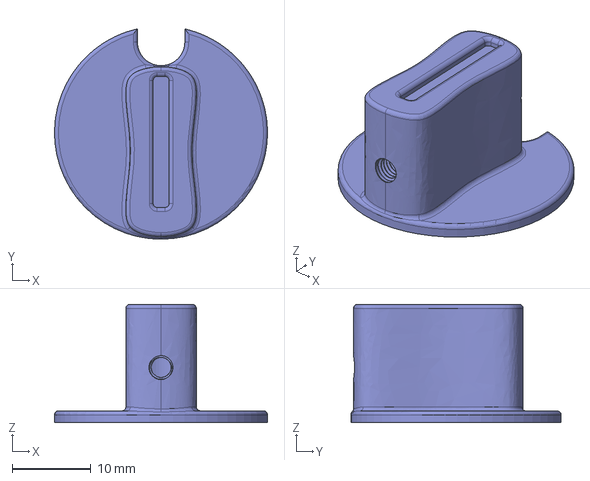
[picture p107: CAD file, 2022-01-05]
Turn DIY Files/Turn RSR-17 DIY Files/CAD Files/.STEP Files/Rotary Encoder Knob.step
27.0 x 26.7 x 15.0 mm
