turnracing/turnracing-diy/(list of files, cad)

Other CAD files:
Turn DIY Files/Turn GT GT3 DIY Files/CAD Files/.STEP Files/Turn GT GT3 Front Plate.step
Turn DIY Files/Turn GT GT3 DIY Files/CAD Files/.STEP Files/Grips/Left Grip front.step
Turn DIY Files/Turn GT GT3 DIY Files/CAD Files/.STEP Files/Right Shifter Spacer.step
Turn DIY Files/Turn GTE DIY Files/3d Printable Files/Button Inserts/Right Rear Button Cover.stl
Turn DIY Files/Turn GTE DIY Files/3d Printable Files/Grips/Grip Right Front.stl
Turn DIY Files/Turn GTE DIY Files/3d Printable Files/Plates/Front Plate.stl
Turn DIY Files/Turn 488 Challenge DIY Files/3d Printable Files/Grips/Turn 488 Challenge Grip Left Rear.stl
Turn DIY Files/Turn 488 Challenge DIY Files/CAD Files/.STEP Files/Turn 488 Challenge Left Paddle.step
Turn DIY Files/Turn GT GT3 DIY Files/3d Printable Files/Shifter Left Spacer.stl
Turn DIY Files/Turn GT GT3 DIY Files/CAD Files/.STEP Files/488 Shifter Paddle Left.step
Turn DIY Files/Turn GTE DIY Files/CAD Files/.STEP Files/Grip Left Rear.step
Turn DIY Files/Turn RSR-17 DIY Files/CAD Files/.STEP Files/Shifter Left Paddle.step
Turn DIY Files/Turn 488 Challenge DIY Files/3d Printable Files/Grips/Turn 488 Challenge Grip Right Front.stl
Turn DIY Files/Turn GT GT3 DIY Files/CAD Files/.STEP Files/488 Shifter Paddle Right.step
Turn DIY Files/Turn GT GT3 DIY Files/CAD Files/.STEP Files/Grips/Right Grip Back.step
Turn DIY Files/Turn GTE DIY Files/3d Printable Files/Button Inserts/Right Button Insert.stl
Turn DIY Files/Turn GTE DIY Files/3d Printable Files/Grips/Grip Right Rear.stl
Turn DIY Files/Turn GTE DIY Files/CAD Files/.STEP Files/Right Button Insert.step
Turn DIY Files/Turn Fiesta WRC DIY Files/CAD Files/.STEP Files/Rotary Knob.step
Turn DIY Files/Turn GT GT3 DIY Files/CAD Files/.STEP Files/Left Shifter Spacer.step
Turn DIY Files/Turn GTE DIY Files/CAD Files/.STEP Files/Grip Left Front.step
Turn DIY Files/Turn R8 LMS DIY Files/CAD Files/.STEP Files/R8 Left Paddle.step
Turn DIY Files/Turn GT GT3 DIY Files/CAD Files/.STEP Files/Rear Plate.step
Turn DIY Files/Turn GTE DIY Files/CAD Files/.STEP Files/Grip Right Rear.step
Turn DIY Files/Turn R8 LMS DIY Files/CAD Files/.STEP Files/Left Front Grip.step
Turn DIY Files/Turn RSR-17 DIY Files/CAD Files/.STEP Files/Left Grip Back.step
Turn DIY Files/Turn GT GT3 DIY Files/CAD Files/.STEP Files/Hub.step
Turn DIY Files/Turn GTE DIY Files/CAD Files/.STEP Files/Left Rear Button Cover.step
Turn DIY Files/Turn R8 LMS DIY Files/CAD Files/.STEP Files/Left Back Grip.step
Turn DIY Files/Turn GTE DIY Files/CAD Files/.STEP Files/Grip Right Front.step
Turn DIY Files/Turn GTE DIY Files/CAD Files/.STEP Files/3d Shifter Spacer.step
Turn DIY Files/Turn GTE DIY Files/CAD Files/.STEP Files/3 inch 70mm spacer.step
Turn DIY Files/Turn RSR-17 DIY Files/CAD Files/.STEP Files/Right Grip Front.step
Turn DIY Files/Turn GTE DIY Files/CAD Files/.STEP Files/Right Rear Button Cover.step
Turn DIY Files/Turn GTE DIY Files/CAD Files/.STEP Files/Hub Rear Plate.step
Turn DIY Files/Turn GTE DIY Files/CAD Files/.STEP Files/Left Button Insert.step
Turn DIY Files/Turn RSR-17 DIY Files/CAD Files/.STEP Files/Right Button Insert.step
Turn DIY Files/Turn GTE DIY Files/CAD Files/.STEP Files/Hub Spacer.step
Turn DIY Files/Turn 488 Challenge DIY Files/3d Printable Files/Turn 488 Challenge Encoder Knob.stl
Turn DIY Files/Turn 488 Challenge DIY Files/3d Printable Files/Turn 488 Challenge Front Plate.stl
Turn DIY Files/Turn 488 Challenge DIY Files/3d Printable Files/Turn 488 Challenge Left Paddle.stl
Turn DIY Files/Turn 488 Challenge DIY Files/3d Printable Files/Turn 488 Challenge Rear Enclosure.stl
Turn DIY Files/Turn 488 Challenge DIY Files/3d Printable Files/Turn 488 Challenge Right Paddle.stl
Turn DIY Files/Turn 911 GT3 Cup DIY Files/3d Printable Files/Hub.stl
Turn DIY Files/Turn 911 GT3 Cup DIY Files/3d Printable Files/Rear Plate.stl
Turn DIY Files/Turn 911 GT3 Cup DIY Files/3d Printable Files/Shifter Paddle Left.stl
Turn DIY Files/Turn 911 GT3 Cup DIY Files/3d Printable Files/Shifter Paddle Right.stl
Turn DIY Files/Turn 911 GT3 Cup DIY Files/3d Printable Files/Turn 911 GT3 Cup Front Plate.stl
Turn DIY Files/Turn Fiesta WRC DIY Files/3d Printable Files/1 Inch Spacer.stl
Turn DIY Files/Turn Fiesta WRC DIY Files/3d Printable Files/Fiesta WRC Front Plate.stl
Turn DIY Files/Turn GT GT3 DIY Files/3d Printable Files/488 Shifter Paddle Left.stl
Turn DIY Files/Turn GT GT3 DIY Files/3d Printable Files/488 Shifter Paddle Right.stl
Turn DIY Files/Turn GT GT3 DIY Files/3d Printable Files/Rear Plate.stl
Turn DIY Files/Turn GT GT3 DIY Files/DXF Files/Turn GT GT3 Front Plate.dxf
Turn DIY Files/Turn GT GT3 DIY Files/Turn 3d Shifter DIY Download/3d Printing Files/Base Bottom.stl
Turn DIY Files/Turn GT GT3 DIY Files/Turn 3d Shifter DIY Download/3d Printing Files/Base Top.stl
Turn DIY Files/Turn GT GT3 DIY Files/Turn 3d Shifter DIY Download/3d Printing Files/Lever.stl
Turn DIY Files/Turn GT GT3 DIY Files/Turn 3d Shifter DIY Download/CAD Files/Completed Assembly/Turn 3d Shifter Assembly (Fusion 360).f3d
Turn DIY Files/Turn GTE DIY Files/3d Printable Files/Shifter Paddle.stl
Turn DIY Files/Turn R8 LMS DIY Files/3d Printable Files/Front Plate.stl
Turn DIY Files/Turn R8 LMS DIY Files/3d Printable Files/R8 Left Paddle.stl
Turn DIY Files/Turn R8 LMS DIY Files/3d Printable Files/R8 Right Paddle.stl
Turn DIY Files/Turn RSR-17 DIY Files/3d Printable Files/Front Plate.stl
Turn DIY Files/Turn RSR-17 DIY Files/3d Printable Files/Left Button Insert.stl
Turn DIY Files/Turn RSR-17 DIY Files/3d Printable Files/Right Button Insert.stl
Turn DIY Files/Turn RSR-17 DIY Files/3d Printable Files/Shifter Base.stl
Turn DIY Files/Turn RSR-17 DIY Files/3d Printable Files/Shifter Left Paddle.stl
Turn DIY Files/Turn RSR-17 DIY Files/3d Printable Files/Shifter Lever.stl
Turn DIY Files/Turn RSR-17 DIY Files/3d Printable Files/Shifter Right Paddle.stl
