turnracing/turnracing-diy/Wiki Images/adafruit_soldering101.png

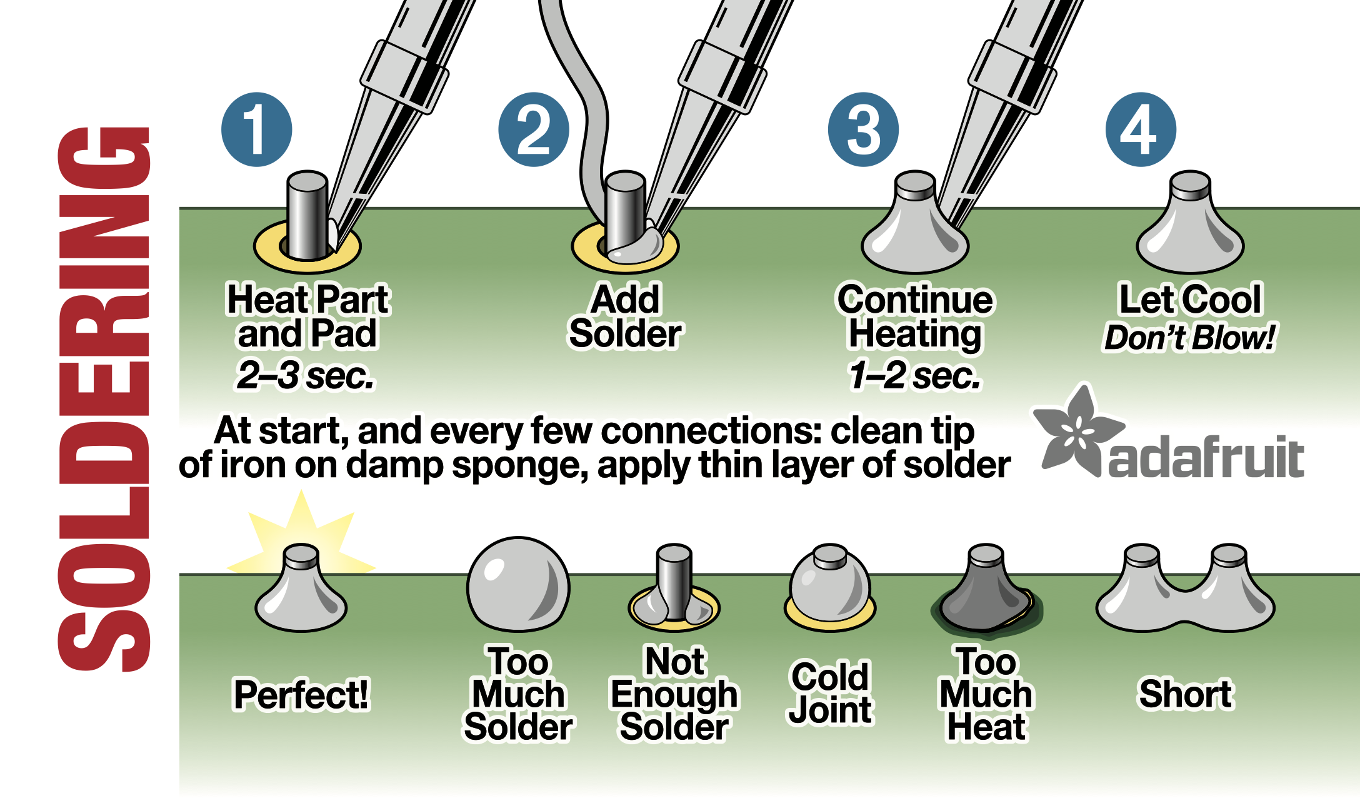
Wiki Images/adafruit_soldering101.png
