turnracing/turnracing-diy/Wiki Images/DIY Molded Grips Guide Image.png

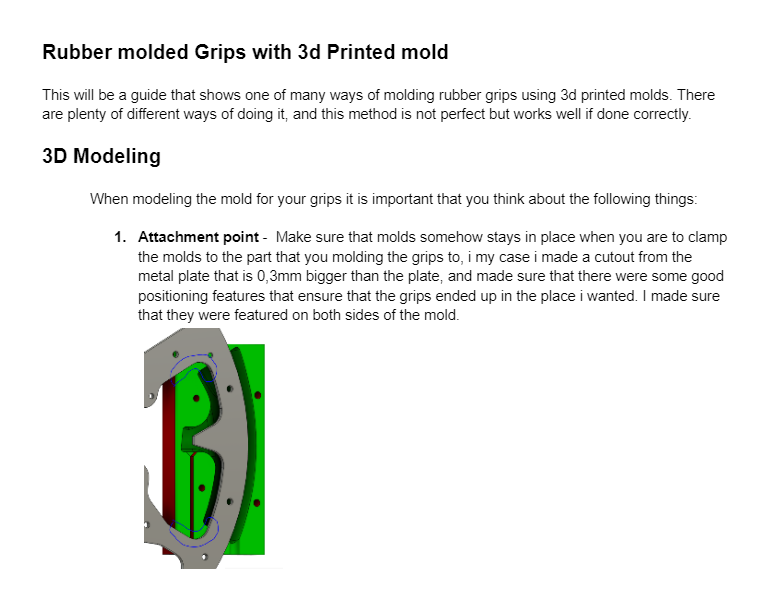
Wiki Images/DIY Molded Grips Guide Image.png
