turnracing/turnracing-diy/Wiki Images/SimHub Rotary Encoder Wiring.png

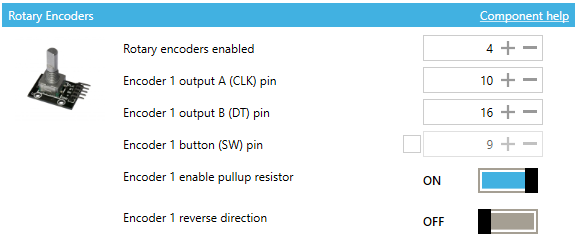
Wiki Images/SimHub Rotary Encoder Wiring.png
