turnracing/turnracing-diy/Wiki Images/USB and Aviation Wiring.jpg

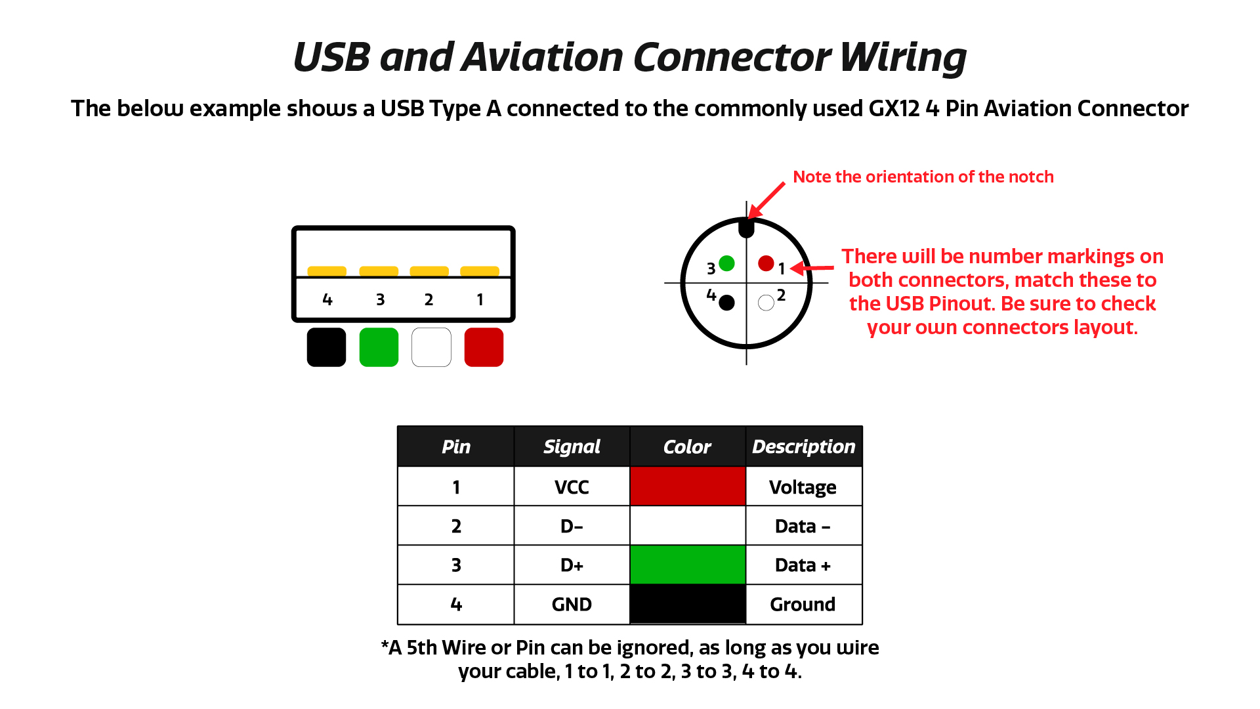
Wiki Images/USB and Aviation Wiring.jpg
