turnracing/turnracing-diy/Turn DIY Files/Turn GT GT3 DIY Files/Templates/Turn GT GT3 Front Plate Drawing 1 to 1 A4 Paper.pdf

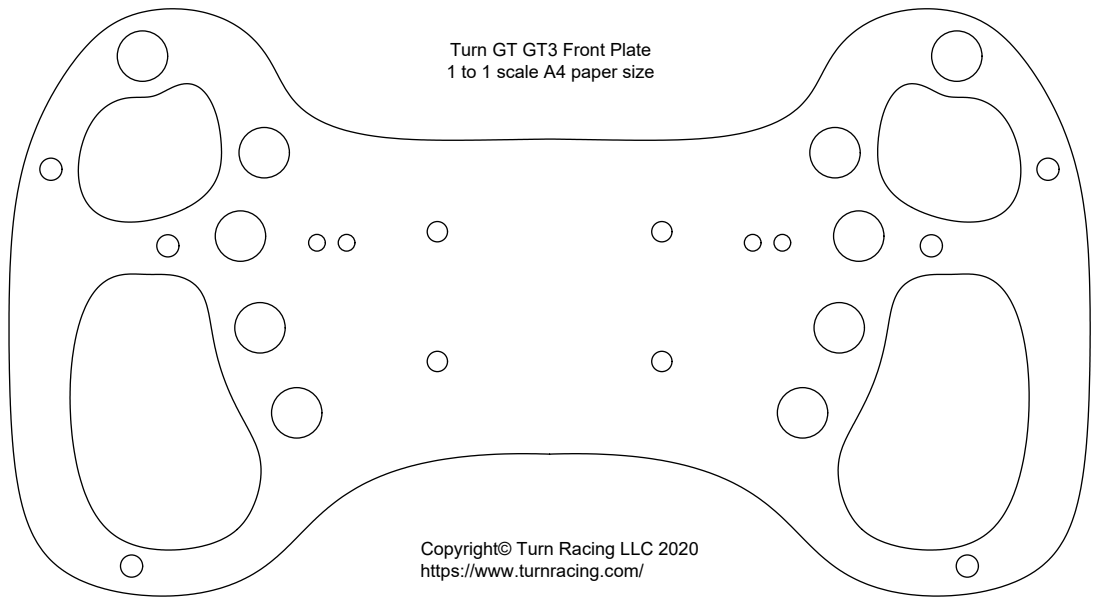
[picture p113: page 1]

Turn GT GT3 Front Plate
1 to 1 scale A4 paper size

Copyright© Turn Racing LLC 2020
https://www.turnracing.com/
