turnracing/turnracing-diy/Wiki Images/Turn_R20_Drawing_1_to_1_Scale_A4_Paper_Size.pdf

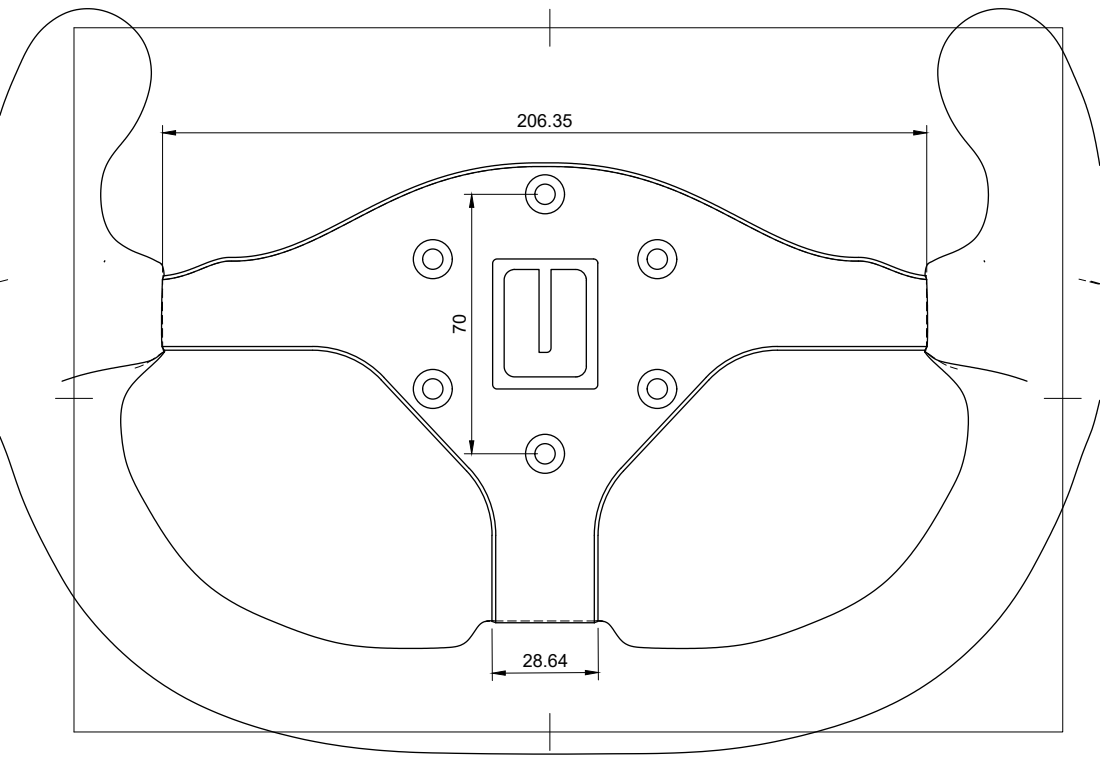
[picture p114: page 1]
