turnracing/turnracing-diy/Turn DIY Files/Turn GTE DIY Files/Templates/Left Grip Suede Template 1 to 1 scale A4 paper size.pdf

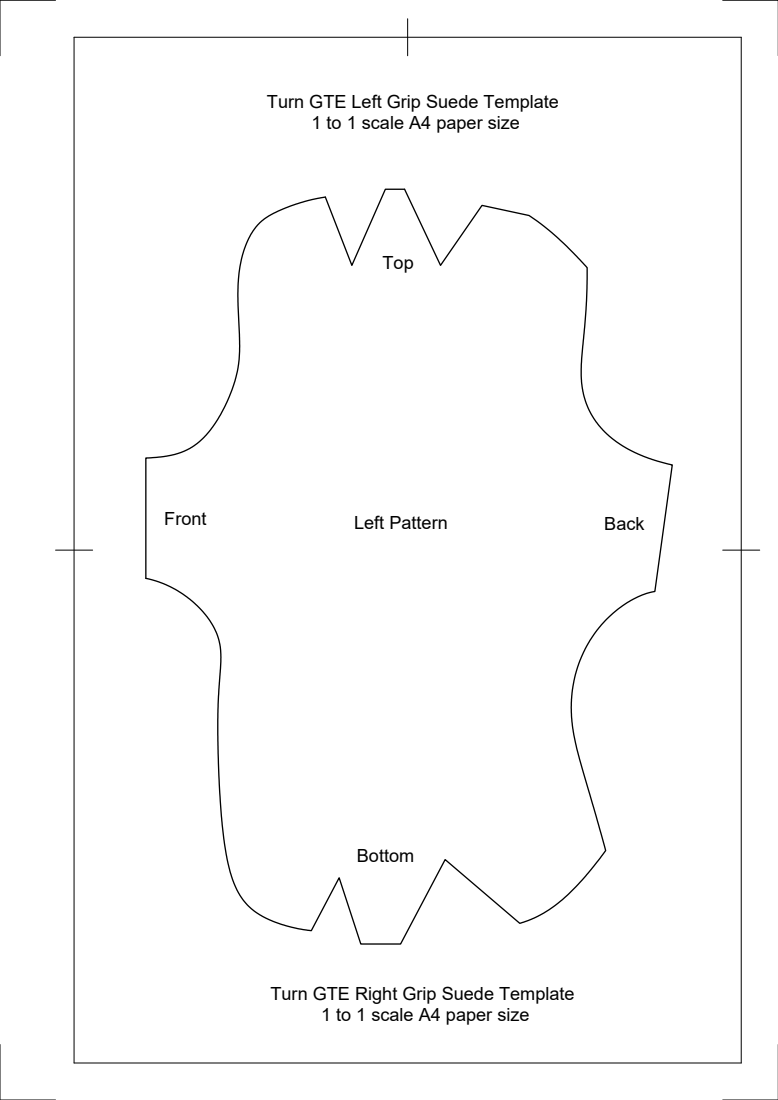
[picture p115: page 1]
Left Pattern

Turn GTE Left Grip Suede Template
1 to 1 scale A4 paper size

Turn GTE Right Grip Suede Template
