turnracing/turnracing-diy/Turn DIY Files/Turn GTE DIY Files/Templates/Right Grip Suede Template 1 to 1 scale A4 paper size.pdf

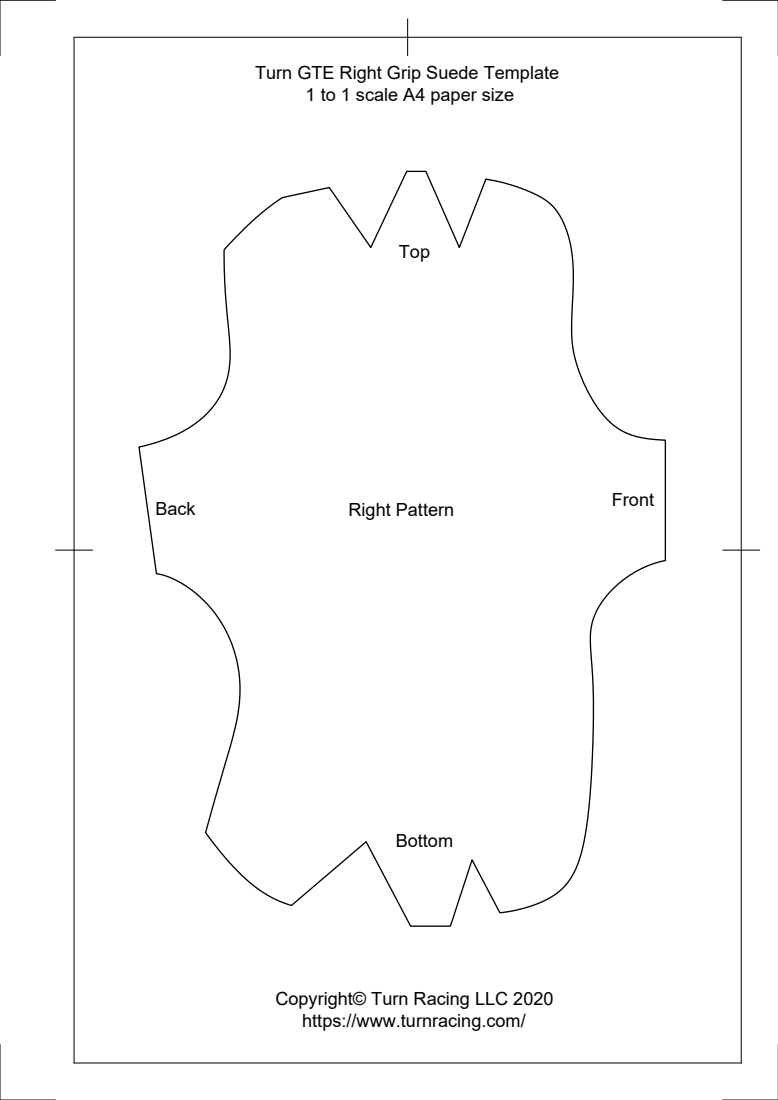
[picture p116: page 1]
Front Back; Right Pattern

Turn GTE Right Grip Suede Template
1 to 1 scale A4 paper size

Copyright© Turn Racing LLC 2020
https://www.turnracing.com/
