turnracing/turnracing-diy/(commit log)

2021-12-28 Update Wheel Size Chart
2022-01-05 Turn DIY Schematics by TezzlaX
2022-01-05 Added Turn DIY Files
    [1 Inch Spacer.step, 1 Inch Spacer.stl, 3 inch 70mm Spacer.stl, 3 inch 70mm spacer.step, 3d Shifter Spacer.step, Ascher Rally Shifter Bracket.step, Base Bottom.step, Base Bottom.stl]
2022-01-05 Added GT DIY Wheel
    [488 Shifter Paddle Left.step, 488 Shifter Paddle Left.stl, 488 Shifter Paddle Right.step, 488 Shifter Paddle Right.stl, Base Bottom.step, Base Bottom.stl, Base Top.step, Base Top.stl]
2022-01-06 Create USB and Aviation Wiring.jpg
2022-01-18 Printed Molds
2022-06-23 Added image for DIY Molded Grips Guide
2022-06-24 Added image for SimHub Rotary Encoder Wiring
2022-07-15 Fusion STL Images
